henry7135/ouma-ria-smart-clock/OUMA CLOCK_ Wiring.pdf

# Connect Dupont jumper wires according to the wiring table

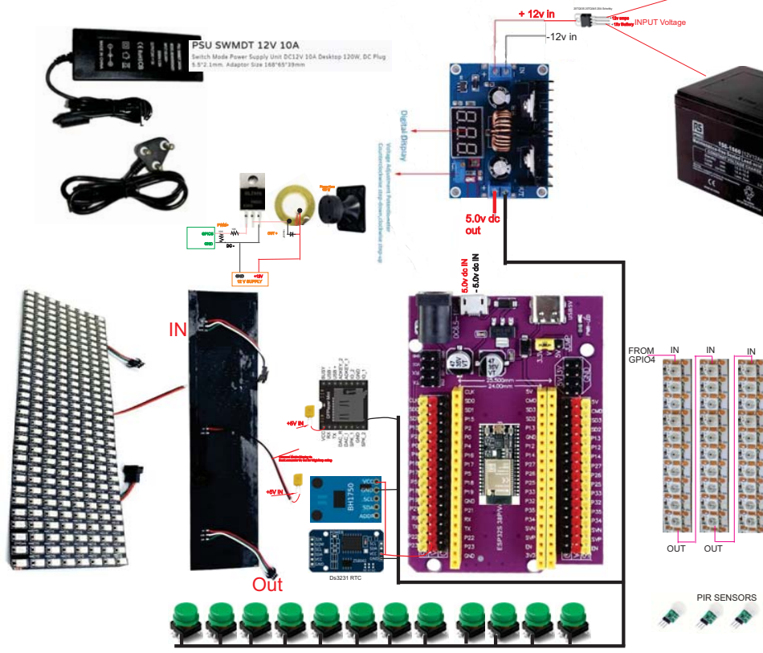
[picture p42: figure]
20TQ035 20TQ045 20A Schottky; 5.0v dc out; Out; OUT; +12v smps +12v Battery INPUT Voltage; Connect Matrix Display to; Ds3231 RTC; 12 V SUPPLY; Piezzo Horn 150 W; OUT +; GND; PWM+; GPIO5; GPIO4; FROM; PIR SENSORS

Buck converter 5v out for HighAmp rating

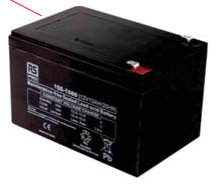
[picture p43: figure]

3w Speaker

Complete Pin Connection Table — from the firmware:

GPIO | Pin on ESP32 | Connect to | Notes
13 | GPIO13 | Matrix DATA IN | Main 16×32 display
4 | GPIO4 | BAR3 strip DATA IN | 30-LED status chain (3 strips in series)
21 | GPIO21 | SDA | DS3231 RTC + BH1750 (shared I²C bus)
22 | GPIO22 | SCL | DS3231 RTC + BH1750 (shared I²C bus)
16 | GPIO16 | DFPlayer TX → ESP RX1kΩ resistor on DFPlayer RX side
17 | GPIO17 | DFPlayer RX ← ESP TX1kΩ resistor in series here
5 | GPIO5 | Siren MOSFET gate | 10kΩ series + 10kΩ pulldown to GND
19 | GPIO19 | Button — MODE (red)
26 | GPIO26 | Button — SET (blue)
27 | GPIO27 | Button — UP (white)
14 | GPIO14 | Button — ALARM ON/OFF (white)
12 | GPIO12 | Button — CHIMES (red)LOW at boot is safe
32 | GPIO32 | Button — VOL UP (blue)
33 | GPIO33 | Button — VOL DOWN (yellow)
34 | External 10kΩ pull-up to 3.3V required GPIO34 | Button — SOUND (yellow) | (input-only pin)
35 | External 10kΩ pull-up to 3.3V required GPIO35 | Button — ALARM SELECT (red) | (input-only pin)
2 | GPIO2 | Button — WIFI RESET (blue)Hold 3s: WiFi/network reset. Short tap: Smoker quick-peek (when running)
18 | GPIO18 | Button — MEDICINE (yellow)
25 | GPIO25 | Button — BIRTHDAY (white)
15 | GPIO15 | PIR Courtyard BAM312 direct, 3.3V power
36 | GPIO36 | PIR Courtyard CInput-only, no internal pull
39 | GPIO39 | PIR Front Door (Zone 2)Input-only, no internal pull
23 | GPIO23 | PIR Passage (Zone 2)
0 | DO NOT USE GPIO0 | — | — boot strap pin
1 | DO NOT USE GPIO1 | — | — USB serial TX
3 | DO NOT USE GPIO3 | — | — USB serial RX / Ch340

Power rails summary:
Rail | Voltage | Feeds
Buck converter out | ESP32 board, DFPlayer, all LEDs 5.0V, 8A
12V PSU | Siren speakers (via IRLZ44N MOSFETs on GPIO5) 12V
Battery backup | Keeps 12V rail alive during loadshedding 12V
ESP32 3.3V out | DS3231, BH1750, AM312 PIR sensors, button pull-ups 3.3V
