henry7135/ouma-ria-smart-clock/Ouma Ria Smart Clock.ino

/******************************************************************************
 *
 *  OUMA RIA SMART CLOCK
 *  Version 1.0  --  Release Candidate 1
 *
 *  Designed and Developed by
 *      Henry Vermaak
 *      Koster, North West
 *      South Africa
 *
 *------------------------------------------------------------------------------
 *
 *  Project Purpose
 *
 *  The OUMA RIA SMART CLOCK is an ESP32-based home information, reminder
 *  and safety system developed to assist people in their everyday lives,
 *  with special attention given to older people living independently.
 *
 *  Every major feature was developed in response to a real-world need
 *  identified during daily use in the author's own home.
 *
 *  
 ******************************************************************************/

/******************************************************************************
 * FEATURE OVERVIEW
 ******************************************************************************/
//    NTP time sync        -- auto-syncs on boot + every 6 hours via WiFi
//    DS3231 RTC           -- temperature-compensated, +/-2ppm, built-in temp sensor
//    BH1750 light sensor  -- automatic day/night display brightness
//    Web config portal    -- browse to the clock's IP to set WiFi, time, volume
//    OTA updates          -- flash new firmware over WiFi, no USB cable needed
//    Automatic WiFi recovery -- reconnects on its own after a power outage,
//                               no button press required (manual backup kept)
//    Medicine reminders   -- up to 4 daily doses, plus two independent short
//                             courses (e.g. two different antibiotics at once)
//                             with Pushover reminders and phone acknowledgement
//    Birthday calendar, doctor appointments, and a general events calendar
//    Shopping / reminder notepad
//    Security alarm       -- 2 zones, 5 PIR sensors, siren, panic button,
//                             Pushover emergency alerts
//    Egg timer, smoker uptimer, braai timer, and a built-in braai times guide
//    Multiple alarms with day-of-week scheduling and snooze
//    Bilingual Afrikaans / English interface throughout
//    All settings stored in NVS -- survive firmware updates and power cuts

/******************************************************************************
 * HARDWARE
 ******************************************************************************/
//    DS3231 RTC         -- I2C  SDA=GPIO21  SCL=GPIO22   VCC=3.3V
//    BH1750 light       -- I2C  shared bus              VCC=3.3V
//    DFPlayer Mini      -- UART2  TX=GPIO17  RX=GPIO16   VCC=5V
//    4x 8x8 WS2812B     -- GPIO13  (470 ohm series resistor)
//    WS2812B 3x10 bar   -- GPIO4  (470 ohm series resistor)
//    Buttons (active LOW, INPUT_PULLUP unless noted):
//      GPIO19  BTN_MODE    -- cycle display modes              (Sw1  Red)
//      GPIO26  BTN_SET     -- adjust / start-pause egg timer    (Sw2  Blue)
//      GPIO27  BTN_UP      -- adjust / dismiss alarm / SNOOZE   (Sw3  White)
//      GPIO14  BTN_ALM     -- toggle alarm on/off               (Sw4  White)
//      GPIO12  BTN_CHIME   -- toggle chimes on/off              (Sw5  Red)
//      GPIO32  BTN_CVUP    -- volume up                         (Sw6  Blue)
//      GPIO33  BTN_CVDN    -- volume down                       (Sw7  Yellow, INPUT only)
//      GPIO34  BTN_SOUND   -- cycle sound set                   (Sw8  Yellow, INPUT only)
//      GPIO35  BTN_ALMSEL  -- reserved / spare                  (Sw9  Red,    INPUT only)
//      GPIO2   BTN_PILL    -- WiFi/network reset (hold 3s)      (Sw10 Blue)
//      GPIO18  BTN_MED     -- medicine confirm                  (Sw11 Yellow)
//      GPIO25  BTN_BDAY    -- birthday/doctor accept            (Sw12 White)
//    GPIO33, 34, 35 are input-only pins with no internal pull-up resistor --
//    fit an EXTERNAL 10K ohm pull-up to 3.3V on each of these three.

/******************************************************************************
 * WIRING SUMMARY
 ******************************************************************************/
//  Component            | Connection
//  --------------------- ----------------------------------------------------
//  DS3231 RTC           | SDA->GPIO21  SCL->GPIO22  VCC->3.3V  GND->GND
//  BH1750               | SDA->GPIO21  SCL->GPIO22  VCC->3.3V  GND->GND  ADDR->GND
//  DFPlayer Mini        | TX2(GPIO17)->DFP_RX  RX2(GPIO16)<-DFP_TX
//                        | 1K ohm resistor on DFPlayer RX pin. VCC->5V  GND->GND
//  WS2812B x4 panels    | DIN->GPIO13 (via 470 ohm)  VCC->5V (3A+)  GND->GND
//  WS2812B 3x10 bar     | DIN->GPIO4 (via 470 ohm)  VCC->5V  GND->GND
//    (one chain, cut      physical  0-9  = pill/appointment day strip
//     from one roll)      physical 10-19 = medicine dose + birthday indicators
//                         physical 20-29 = status: alarms, security, internet,
//                                          calendar, courtyard-armed, wekkers
//  Buttons x12          | one pin -> GPIO   other pin -> GND
//    GPIO33, 34, 35       EXTERNAL 10K ohm pull-up to 3.3V required
//    (input-only pins)    (no internal pull-up on 33/34/35/36/39)
//  Siren (piezo)         | GPIO5 -> IRLZ44N MOSFET gate, 10K series resistor,
//                          10K pull-down resistor to GND (prevents a boot chirp)
//  PIR sensors x5        | AM312, 3.3V, direct to GPIO, no divider needed

/******************************************************************************
 * DISPLAY MODES
 ******************************************************************************/
//    0 = Clock             amber
//    1 = Alarm set          cyan
//    2 = Egg timer run     green
//    3 = Egg timer set    orange
//    4 = Temperature      magenta (DS3231 built-in sensor, C or F)
//    5 = Uptime              blue (days.hours since boot)
//    Long-press BTN_MODE (>1s) toggles 12hr / 24hr display

/******************************************************************************
 * NETWORK, OTA & WEB PORTAL
 ******************************************************************************/
//    First boot: the clock creates a WiFi setup AP -- connect a phone to it
//    and follow the captive portal to enter your home WiFi credentials and
//    timezone offset. After that it connects automatically on every boot,
//    and retries automatically in the background if WiFi is down or drops
//    (loadshedding-safe -- no button press needed under normal conditions;
//    a manual hold-3-seconds reset button and a Restart button in /config
//    remain available as a backup). Time syncs on boot and every 6 hours.
//
//    OTA updates: Arduino IDE -> Sketch -> Upload -> select the clock's
//    network port. Set your own OTA_PASSWORD before flashing a real device.
//
//    Web portal pages include: / (status), /alarms, /wekkers, /medicine,
//    /calendar, /notepad, /alarm (security), /config, /set, /ota, and
//    several on-device reference pages (LED colour guide, button guide,
//    braai times).

/******************************************************************************
 * LIBRARIES (install via Arduino Library Manager)
 ******************************************************************************/
//    FastLED          by Daniel Garcia
//    RTClib           by Adafruit               (DS3231 driver)
//    BH1750           by Christopher Laws
//    WiFiManager      by tzapu                  (captive portal WiFi setup)
//    ArduinoOTA       (built into ESP32 Arduino core)
//    WebServer        (built into ESP32 Arduino core)
//    Preferences      (built into ESP32 Arduino core)
//    Wire             (built into ESP32 Arduino core)
//    time.h / sntp.h  (built into ESP32 Arduino core)
//    NOTE: DFRobotDFPlayerMini library is NOT needed -- a direct serial
//    driver is used instead.

/******************************************************************************
 * BOARD SETTINGS (Arduino IDE)
 ******************************************************************************/
//    Board:      ESP32 Dev Module
//    Flash Size: 4MB
//    Partition:  "Minimal SPIFFS (Large APPS with OTA)" -- REQUIRED for OTA;
//                do not use a "Huge APP" scheme, it removes the second OTA
//                app slot and disables over-the-air updates entirely.
//    CPU Speed:  240MHz
//    Upload:     921600 baud


// ── Arduino / ESP32 Core ──────────────────────────────────────────────────
#include <Arduino.h>
#include <Wire.h>                // I2C bus — shared by the RTC and light sensor
#include <time.h>                // system time / NTP (configTime, getLocalTime)

// ── Communications ──────────────────────────────────────────────────────────
#include <WiFiManager.h>         // tzapu WiFiManager — captive portal WiFi setup
#include <ESPmDNS.h>             // http://oumariaclock.local
#include <WiFiClientSecure.h>    // HTTPS client — Pushover notifications

// ── Display ────────────────────────────────────────────────────────────────
#include <FastLED.h>             // WS2812B main matrix + status strip

// ── RTC ────────────────────────────────────────────────────────────────────
#include <RTClib.h>              // Adafruit RTClib — DS3231 real-time clock

// ── Sensors ────────────────────────────────────────────────────────────────
#include <BH1750.h>              // ambient light sensor — auto-brightness

// ── Audio ──────────────────────────────────────────────────────────────────
// (none — DFPlayer Mini uses a direct UART serial driver, no library needed)

// ── Storage ────────────────────────────────────────────────────────────────
#include <Preferences.h>         // NVS key-value storage — all settings persist here

// ── Web Server ─────────────────────────────────────────────────────────────
#include <WebServer.h>           // config portal + status pages
#include <ArduinoOTA.h>          // over-the-air firmware updates

/******************************************************************************
 * VERSION INFORMATION
 ******************************************************************************/
#define FW_NAME        "OUMA RIA SMART CLOCK"
#define FW_VERSION     "1.0"
#define FW_STATUS      "Release Candidate 1"
#define FW_AUTHOR      "Henry Vermaak"

#define FIRMWARE_VERSION   FW_NAME " v" FW_VERSION   // used for the web footer / serial banner

/******************************************************************************
 * PIN DEFINITIONS — every physical GPIO assignment, in one place
 ******************************************************************************/
#define WS_PIN       13   // Main matrix WS2812B data
#define BTN_MODE     19   // NOTE: physical GPIO25 has a confirmed ~100 ohm stray
                          // leakage fault on this specific ESP32 module (measured
                          // directly on the pin with the button and wire fully
                          // removed — not a wiring/switch issue). BTN_MODE was
                          // moved here to GPIO19 and BTN_BDAY moved to GPIO25 below
                          // (a low-consequence role: its logic only fires silently
                          // when nothing is due, so a stray trigger there is
                          // harmless, unlike MODE's long-press which was falsely
                          // toggling C/F at every boot). Physical button wiring to
                          // be swapped to match — see BTN_BDAY comment below.
#define BTN_SET      26
#define BTN_UP       27
#define BTN_ALM      14
#define BTN_CHIME    12
#define BTN_CVUP     32
#define BTN_CVDN     33
#define BTN_SOUND    34   // input-only — needs external 10K pull-up to 3.3V
#define BTN_ALMSEL   35   // input-only — needs external 10K pull-up to 3.3V
#define BTN_PILL      2   // pill confirm / repurposed: hold 3s = WiFi/network reset
#define BTN_MED      18   // medicine confirm (INPUT_PULLUP)
#define BTN_BDAY     25   // birthday/doctor accept (INPUT_PULLUP) — deliberately
                          // parked on the faulty pin (see BTN_MODE note above).
                          // Physical wires: swap the MODE and BIRTHDAY button
                          // wires between GPIO19 and GPIO25 so the panel labels
                          // once again match their real function.
#define DFP_RX_PIN   16   // ESP32 RX ← DFPlayer TX
#define DFP_TX_PIN   17   // ESP32 TX → DFPlayer RX
#define BAR3_PIN      4   // single WS2812B data pin — ONE chain, cut from one roll:
                          //   physical 0-9   = day-of-week / pill strip
                          //   physical 10-19 = medicine dose + birthday/doctor LEDs
                          //   physical 20-29 = free/status bar (alarm, internet, calendar...)
#define PIR_PARKED  255   // sentinel: PIR slot with no GPIO — always reads "no motion"
#define PIR1_PIN   PIR_PARKED // Zone 1 Courtyard sensor A — no free GPIO remains on
                          // this board; see the wiring note further down for a
                          // PCF8575 I2C expander as the clean way to add it back
#define PIR2_PIN     15   // Zone 1 Courtyard sensor B  (INPUT, always armed)
                          // GPIO15 LOW at boot is safe — only silences ROM boot log
#define PIR3_PIN     36   // Zone 1 Courtyard sensor C  (input-only, always armed)
#define PIR4_PIN     39   // Zone 2 Front door/Entrance (input-only, arm-away only)
#define PIR5_PIN     23   // Zone 2 Passage/Lounge      (INPUT,      arm-away only)
#define SIREN_PIN     5   // IRLZ44N MOSFET gates — needs 10K gate pulldown resistor

/******************************************************************************
 * CONSTANTS — global, cross-cutting values. Subsystem-local sizing constants
 * (e.g. how many Kort Kursus slots, how many calendar events) stay next to
 * the struct/array they configure, further down in each subsystem's section.
 ******************************************************************************/

// -- Firmware behaviour -------------------------------------------------------
#define PILLS_ENABLED  0   // 0 = daily-pills subsystem disabled (the Medicine
                           // schedule below covers it). Set to 1 to re-enable.
#define SPLASH_MAJOR  1   // boot splash scrolls "V <MAJOR>.<MINOR>" on the LED
#define SPLASH_MINOR  0   // matrix — UPDATE THESE TOGETHER WITH FW_VERSION!
                          // (single digits 0-9 only: they index FONT5 directly)

// -- NTP / time ----------------------------------------------------------------
#define NTP_SERVER1        "pool.ntp.org"
#define NTP_SERVER2        "time.google.com"
#define NTP_SYNC_INTERVAL  (6UL * 3600UL)     // resync every 6 hours (seconds)

// -- WiFi / network --------------------------------------------------------------
// If WiFi can't connect (or drops mid-session, e.g. a power outage), the
// clock keeps retrying by itself in the background, forever, with no button
// press or menu needed. See wifi_connect_with_retries() and the WiFi-health
// check inside wifi_task()'s main loop.
#define OTA_PASSWORD       "CHANGE_ME"        // set your own password before flashing
#define WIFI_CONNECT_ATTEMPT_TIMEOUT_MS   15000            // how long ONE attempt waits before giving up
#define WIFI_RETRY_FIRST_WAIT_MS          (60UL * 1000UL)  // wait 60s before the very first retry
#define WIFI_RETRY_INTERVAL_MS            (3UL * 60UL * 1000UL)  // then retry every 3 minutes, forever
#define WIFI_HEALTH_CHECK_INTERVAL_S      60               // how often to notice a mid-session drop
#define WIFI_BTN_HOLD_MS                  3000             // hold BTN_PILL this long for a manual WiFi/reboot reset
#define INET_CHECK_INTERVAL               30               // seconds between internet-reachability probes
// Diagnostic switch — set to 0 to fully disable WiFi/NTP/OTA/webserver, e.g.
// for isolating whether background WiFi activity affects DFPlayer audio.
#define ENABLE_WIFI  1

// -- Rollover-safe millis() deadline check ----------------------------------------
// Fixes a subtle rollover bug found on review: code of the form
//   end = millis() + duration;   ... later ...   if (millis() >= end) { ... }
// looks fine, but millis() wraps back to 0 roughly every 49.7 days. If a
// timer is armed close enough to the wrap that "millis() + duration" itself
// overflows past 4,294,967,295, "end" comes out as a SMALL number even
// though it represents a point still in the future — and a plain ">="
// comparison then trips immediately (or in the case of "<", never trips),
// firing early or late for one timer, exactly once, until the wrap has
// fully passed. Unsigned subtraction doesn't have this problem: casting
// the difference to a signed 32-bit value gives the correct sign even
// across a wraparound, as long as the two timestamps are within ~24.8 days
// of each other (true for every timer in this firmware — all are seconds
// long). Use TIME_REACHED(now, deadline) wherever a "millis() + duration"
// deadline is compared against the current time.
#define TIME_REACHED(now, deadline)  ((int32_t)((now) - (deadline)) >= 0)

// -- General behaviour -----------------------------------------------------------
#define BUTTON_SETTLE_MS   2000                // ignore hold/long-press logic for this
                                                // long after loop() first starts scanning
                                                // buttons — lets every GPIO settle through
                                                // its pull-up before the firmware trusts it
#define SNOOZE_MINUTES     9
#define SMOKE_PEEK_MS      5000                // how long the quick smoker-uptime peek stays on screen
#define NIGHT_START        18   // winter — sun sets 18:00
#define NIGHT_END           7   // winter — sun rises 07:00
#define NUM_ALARM_SLOTS    3

// -- Security alarm timing --------------------------------------------------------
#define ZONE1_COUNT  3    // Outdoor courtyard sensors  (24/7, immediate siren)
#define ZONE2_COUNT  2    // Indoor sensors             (away mode, entry delay)
#define PIR_COUNT    5
#define ALARM_EXIT_DELAY_S   30
#define ALARM_ENTRY_DELAY_S  30
#define ALARM_SIREN_TIMEOUT_S   180   // PIR alarm auto-resets after 3 minutes (power-saving when away)
#define PANIC_SIREN_TIMEOUT_S   900   // Panic siren runs 15 minutes independently
#define DISARM_LOCKOUT_MS      8000   // 8s lockout — covers AM312 worst-case hold time

// -- Pushover / notifications ------------------------------------------------------
// Get your own free credentials at https://pushover.net :
//   1. Create an account and install the Pushover app on your phone.
//   2. Your "User Key" is shown on the dashboard after login.
//   3. Create an "Application" (Settings > Applications > Create New App)
//      to get an "API Token/Key". Name it whatever you like.
// Paste your own values below. NEVER commit real tokens to a public repo.
#define PO_APP_TOKEN  "YOUR_PUSHOVER_APP_TOKEN_HERE"
#define PO_USER_KEY   "YOUR_PUSHOVER_USER_KEY_HERE"
#define PO_HOST       "api.pushover.net"
#define PO_QUEUE_SIZE 8
#define PO_RETRY_SECS   60     // priority-2 re-alert interval (panic/intruder)
#define PO_EXPIRE_SECS  3600   // priority-2 gives up after this (1 hour)
// Medicine reminder pacing — gentler than panic: re-alert every 5 min for up
// to 30 min, until someone taps Acknowledge in the Pushover app.
#define MED_PUSHOVER        1     // 0 = no Pushover for medicine doses
#define MED_PO_LEAD_MIN     5     // warn the phone this many minutes BEFORE the dose
#define MED_PO_RETRY_SECS   300
#define MED_PO_EXPIRE_SECS  1800

// -- Display / LED hardware --------------------------------------------------------
#define NUM_LEDS     256
#define LED_TYPE     WS2812B
#define COLOR_ORDER  GRB
#define BAR3_NUM_LEDS  30
#define MED_NUM_LEDS  8   // Sunlephant board (we use up to 4 = max doses)
#define PILL_NUM_LEDS 8   // Sunlephant 8 LEDs (we use 7 = Sun-Sat, LED7 off)

// -- Display / LED layout — index positions on the shared BAR3 strip --------------
#define PILL_BASE       0
#define MED_BASE       10
#define FREE_BASE      20
#define BDAY_LED_3   4    // med_leds[4] = 3 days before birthday
#define BDAY_LED_2   5    // med_leds[5] = 2 days before birthday
#define BDAY_LED_1   6    // med_leds[6] = tomorrow / today birthday
#define DOC_LED      7    // pill_leds[7] = doctor appointment indicator

// -- Audio track numbers (DFPlayer SD card) ----------------------------------------
#define MED_TRACK    62   // "Medisyne tyd Ouma!"  — above all chime tracks (max=53)
#define BDAY_TRACK   63   // birthday song
#define DOC_TRACK    64   // "Doktersafspraak vandag!"
#define PILL_TRACK   61   // "Pille geneem!" (PILLS_ENABLED only)

// -- Medicine / birthday / doctor limits ------------------------------------------
#define MED_MAX_DOSES 4   // maximum doses per day
#define MED_START_HH  7   // medicine window start hour (07:00)
#define MED_END_HH   19   // medicine window end hour  (19:00)
#define BDAY_MAX     30   // maximum birthday entries (30 — lots of grandchildren!)
#define DOC_MAX      10   // maximum doctor appointment entries

/******************************************************************************
 * SECURITY ALARM — WIRING NOTES
 ******************************************************************************/
//  GPIO 0, 1 and 3 are NOT used for any peripheral on this board. GPIO0 is
//  the boot-strapping pin (must read HIGH at reset, or the board drops into
//  the serial bootloader); a sensor idling LOW there can prevent boot
//  entirely. GPIO1 carries the boot log at every reset. GPIO3 is driven by
//  the on-board USB-serial chip whenever the board is powered through its
//  USB socket — loading a peripheral onto it caused real, hard-to-diagnose
//  failures (intermittent notification/Wi-Fi problems) during development.
//  Treat all three as reserved for USB/serial only.
//
//  PIR sensors: AM312 — VCC=3.3V, GND=GND, OUT→GPIO (direct, no resistor needed)
//  Siren: 2x piezo tweeter, each via an IRLZ44N MOSFET
//    GPIO5 ──[10KΩ series]──► Gate IRLZ44N #1  Drain→Speaker1(-)  Source→GND
//    GPIO5 ──[10KΩ series]──► Gate IRLZ44N #2  Drain→Speaker2(-)  Source→GND
//    Both Speaker(+) → 12V supply.  Add a 1N4007 diode across each speaker.
//    REQUIRED: one 10KΩ pull-down resistor from the gate side to GND (a
//    single shared resistor covers both gates; ready-made 2-channel MOSFET
//    driver modules usually include one) — this defeats GPIO5's weak
//    internal pull-up at reset so the siren can't chirp during boot.
//  PIR1 (Zone 1 Courtyard A) has no free GPIO left on this board and is
//  parked (see PIR1_PIN in Pin Definitions above) — a PCF8575 I2C expander
//  is the clean way to add it back if you have a free I2C address to spare.

/******************************************************************************
 * GLOBAL VARIABLES — organized by subsystem, subsystem-local sizing
 * constants (array/struct sizing) stay right next to the variables they
 * configure rather than living in the Constants block above.
 ******************************************************************************/

// -- Pushover — runtime state -----------------------------------------------
// Result of the most recent po_send attempt — shown on /alarm and /potest so
// Pushover problems are diagnosable from the phone, no serial cable needed.
String g_po_last = "geen poging nog / no attempt yet";


/******************************************************************************
 * 5x7 FONT — clean outline style (open/hollow, like a 7-segment display)
 ******************************************************************************/
// Indices: 0-9 digits, 10=colon, 11=space, 12=V, 13=dot, 14=dash, 15=C, 16=F
//          17=° degree symbol
// Bit 6 = top row, bit 0 = bottom row. Each byte is one vertical column.
const uint8_t FONT5[18][5] = {
  {0x7F,0x41,0x41,0x41,0x7F},  //  0  full border, hollow centre
  {0x00,0x42,0x7F,0x40,0x00},  //  1  serif top-left + vertical bar + foot
  {0x79,0x49,0x49,0x49,0x4F},  //  2  top-right + mid + bottom-left
  {0x49,0x49,0x49,0x49,0x7F},  //  3  mid + right side full
  {0x0F,0x08,0x08,0x08,0x7F},  //  4  top-left + mid + right
  {0x4F,0x49,0x49,0x49,0x79},  //  5  top-left + mid + bottom-right
  {0x7F,0x49,0x49,0x49,0x79},  //  6  left side + mid + bottom-right
  {0x01,0x01,0x01,0x01,0x7F},  //  7  top bar + right side
  {0x7F,0x49,0x49,0x49,0x7F},  //  8  full border + mid bar
  {0x4F,0x49,0x49,0x49,0x7F},  //  9  top-left + mid + right side
  {0x00,0x36,0x36,0x00,0x00},  // 10  colon — two small dots
  {0x00,0x00,0x00,0x00,0x00},  // 11  space
  {0x3F,0x40,0x40,0x40,0x3F},  // 12  V — outline chevron
  {0x00,0x60,0x60,0x00,0x00},  // 13  dot — bottom area
  {0x08,0x08,0x08,0x08,0x08},  // 14  dash / minus
  {0x38,0x44,0x44,0x44,0x00},  // 15  c — baseline aligned with digits (Oupa's view)
  {0x7F,0x09,0x09,0x01,0x01},  // 16  F — top + mid bars + left side
  {0x06,0x09,0x09,0x06,0x00},  // 17  ° — small open circle
};

// ── Colour themes ─────────────────────────────────────────────────────────────
// Index:  0=clock  1=alarmset  2=egg  3=temp  4=uptime
const uint8_t THR[5] = {255,   0,   0, 220,   0};
const uint8_t THG[5] = {140, 220, 200,   0, 100};
const uint8_t THB[5] = {  0, 220,   0, 220, 255};

// ── FastLED array ─────────────────────────────────────────────────────────────
CRGB leds[NUM_LEDS];
CRGB pill_leds[PILL_NUM_LEDS];   // Sunlephant day-of-week LEDs (mirrored into bar3_leds)
CRGB med_leds[MED_NUM_LEDS];     // Sunlephant medicine dose LEDs (mirrored into bar3_leds)
CRGB bar3_leds[BAR3_NUM_LEDS];   // THE physical 30-LED chain on BAR3_PIN: pills+meds+free/status

// ── Hardware objects ──────────────────────────────────────────────────────────
RTC_DS3231   rtc;
BH1750       lightMeter;
WebServer    webServer(80);

// ── Time globals ──────────────────────────────────────────────────────────────
uint8_t  g_hh = 12, g_mm = 0, g_ss = 0;
uint8_t  g_day = 1, g_month = 1;   // for date display
uint16_t g_year = 2026;            // Full year, kept fresh by rtc_sync()
uint8_t  g_dow  = 0;               // Day of week 0=Sun..6=Sat, cached by rtc_sync()
int16_t  g_tz_offset_hours = 2;    // timezone offset from UTC (e.g. SAST = +2)
bool     g_use_12hr  = false;       // 12hr/24hr display
bool     g_temp_degF = false;       // false=°C (default), true=°F — separate from clock mode
bool     g_ntp_synced = false;     // true after first NTP sync
// Once-per-minute latch, set in the 1s tick — replaces
// all the fragile "g_ss == 0" exact-second triggers. See timekeeping().
bool     g_new_minute = false;


// -- Medicine schedule globals ------------------------------------------------
// Dose times: set via web portal, saved to NVS
// doses_per_day = 0 means medicine finished / no current script
struct MedDose {
  uint8_t hh;       // hour
  uint8_t mm;       // minute
  bool    taken;    // confirmed taken today
};

uint8_t  g_med_doses     = 2;       // doses per day: 0,1,2,3,4
MedDose  g_med[MED_MAX_DOSES] = {   // default schedule
  { 7,  0, false},   // dose 1: 07:00
  {13,  0, false},   // dose 2: 13:00
  {19,  0, false},   // dose 3: 19:00 (used when doses>=3)
  {16,  0, false},   // dose 4: 16:00 (used when doses==4)
};
bool     g_med_btn_prev   = false;  // debounce for medicine button
uint8_t  g_med_alm_active  = 255;   // which dose is currently alarming (255=none)
uint32_t g_med_last_day    = 255;   // day-of-week when med was last reset

// -- Kort Kursus / Short Course globals (LED 7 on Strip 2) --
// TWO independent course slots — Ria's own real case: two different
// antibiotics for pneumonia, on two different schedules, running at the
// same time. One shared course slot couldn't hold both. Same
// pattern as the three Wekkers slots — each course is fully independent:
// own name, own dose count/times, own day countdown. Struct-based so the
// slot count can grow later by just changing COURSE_SLOTS.
#define COURSE_SLOTS     2
#define COURSE_MAX_DOSES 4
struct Course {
  char    name[24];                          // e.g. "Ciprofloxactin 500mg"
  uint8_t doses;                              // 0 = this slot is inactive
  uint8_t hh[COURSE_MAX_DOSES];
  uint8_t mm[COURSE_MAX_DOSES];
  bool    taken[COURSE_MAX_DOSES];
  uint8_t days_total;
  uint8_t days_left;                          // counts down; 0 = inactive/finished
  uint8_t last_day;                           // g_day when this slot last rolled over
};
Course   g_course[COURSE_SLOTS] = {
  { "", 0, {8, 14, 20, 0}, {0,0,0,0}, {false,false,false,false}, 0, 0, 255 },
  { "", 0, {9, 21,  0, 0}, {0,0,0,0}, {false,false,false,false}, 0, 0, 255 },
};
uint8_t  g_course_alm_slot = 255;   // which slot is currently alarming (255=none)
uint8_t  g_course_alm_dose = 255;   // which dose within that slot

// -- Ad-hoc extra dose log ----------------------------------------------------
// Henry's follow-up: the Kort Kursus scheduler (above) covers a real course
// with fixed times, but there's a SEPARATE everyday need it doesn't cover —
// an unscheduled one-off, e.g. "Ouma needs an extra painkiller right now."
// No time to set, no multi-day count, just "log that this happened today."
// This is what the old single on/off toggle actually did, restored here as
// its own simple log rather than folded into the scheduled course.
#define ADHOC_MAX_LOG 6
uint8_t  g_adhoc_count    = 0;               // how many logged today
uint8_t  g_adhoc_hh[ADHOC_MAX_LOG];          // time of each log entry
uint8_t  g_adhoc_mm[ADHOC_MAX_LOG];
uint8_t  g_adhoc_last_day = 255;             // day-of-week reset detector, same pattern as med_check_reset

// ── Birthday Calendar globals ─────────────────────────────────────────────────
struct Birthday {
  uint8_t  day;          // 1–31
  uint8_t  month;        // 1–12
  char     name[14];     // first name, max 13 chars + null
};
Birthday g_bdays[BDAY_MAX];
uint8_t  g_bday_count       = 0;    // how many entries are set
bool     g_bday_today       = false; // someone has a birthday today
uint8_t  g_bday_today_idx   = 255;  // index of today's birthday (255 = none)
bool     g_bday_acked        = false; // accept button pressed today — stop flashing
uint8_t  g_bday_last_day    = 255;  // day-of-month when we last checked/reset ack
bool     g_bday_played      = false; // MP3 already played today
bool     g_bday_btn_prev    = false; // debounce for BTN_BDAY

// ── Doctor Appointment Calendar globals ───────────────────────────────────────
struct DocAppt {
  uint8_t  day;          // 1–31
  uint8_t  month;        // 1–12
  char     desc[16];     // short description e.g. "Dr Botha" max 15 chars
};
DocAppt  g_docs[DOC_MAX];
uint8_t  g_doc_count      = 0;    // how many appointments are set
bool     g_doc_today      = false; // appointment today
uint8_t  g_doc_today_idx  = 255;  // index of today's appointment
bool     g_doc_acked      = false; // accept button pressed today
uint8_t  g_doc_last_day   = 255;  // day-of-month when ack last reset
bool     g_doc_played     = false; // MP3 already played today
bool     g_doc_warned     = false; // evening-before warning already played

// ── Kalender general-event globals ──────────────────
// General events ("Ria vergadering", "kar diens") for the /calendar month
// grid. Same day/month + auto-purge pattern as doctor appointments — no year
// stored, past events purge once the date wraps. LED: BAR3 slot 28.
#define EVT_MAX 20
struct Evt {
  uint8_t  day;          // 1–31
  uint8_t  month;        // 1–12
  char     desc[24];     // short description, max 23 chars + null
};
Evt      g_events[EVT_MAX];
uint8_t  g_evt_count      = 0;
bool     g_evt_today      = false;  // any event today (drives LED pulse)
bool     g_evt_acked      = false;  // accept button pressed today — stop flashing
int16_t  g_evt_days_min   = 999;    // days to the NEAREST upcoming event
uint8_t  g_evt_last_day   = 255;    // new-day detector for purge + notify reset
bool     g_evt_notified   = false;  // 07:00 Pushover sent today

// ── Notaboekie globals (Ouma's request) ─────────────────────────────────────
// Small shopping/reminder notes: tap ✓ to strike through when bought, X to
// delete, "Vee gedoen uit" clears all completed. NVS-persisted like all else.
#define NOTE_MAX 20
struct Note {
  char text[41];   // max 40 chars
  bool done;
};
Note     g_notes[NOTE_MAX];
uint8_t  g_note_count = 0;

// -- Pill reminder globals ---------------------------------------------------
bool     g_pill_taken     = false;   // did Ouma take her pills today?
uint8_t  g_pill_last_day  = 255;     // day-of-week when pill was last confirmed
uint8_t  g_pill_alm_hh    = 8;       // pill reminder alarm hour
uint8_t  g_pill_alm_mm    = 0;       // pill reminder alarm minute
bool     g_pill_alm_en    = true;    // pill reminder alarm enabled
bool     g_pill_alm_fire  = false;   // pill reminder currently firing
bool     g_pills_active   = true;    // true = Ouma must take daily pills (set via web portal)
uint32_t g_pill_pulse_ms  = 0;       // for pulsing the LEDs during alarm
bool     g_pill_btn_prev  = false;   // debounce for pill button

// ── WiFi/network reset button (repurposed GPIO2/BTN_PILL, pill subsystem
// retired — see wifi_reset_check_button()) ─────────────────────────────────
bool     g_wifi_btn_prev     = false;   // debounce
uint32_t g_wifi_btn_down_ms  = 0;       // millis() when button was first pressed (0 = not held)
bool     g_wifi_btn_fired    = false;   // true once this press has already triggered a restart

// -- Alarm ----------------------------------------------------------------------
// A single daily wake alarm — no day-of-week mask, fires every day.
struct Alarm {
  uint8_t hh;
  uint8_t mm;
  bool    enabled;
};
Alarm g_alarm1 = {6, 30, true};

// -- Wekkers — three independent daily alarms, separate from the wake alarm ------
// above. Each has its own time, its own day-of-week mask, and its own
// enabled state. A firing Wekker repeats every WEKKER_REPEAT_MS (0002.mp3 is
// short enough to miss on a single play) until acknowledged via BTN_BDAY —
// the same accept/dismiss button shared with birthdays and doctor
// appointments — or until WEKKER_MAX_REPEATS is reached.
bool    g_wekker_enabled[NUM_ALARM_SLOTS]     = {false, false, false};
uint8_t g_wekker_hh[NUM_ALARM_SLOTS]          = {6, 7, 8};
uint8_t g_wekker_mm[NUM_ALARM_SLOTS]          = {0, 0, 0};
uint8_t g_wekker_days[NUM_ALARM_SLOTS]        = {0x7F, 0x7F, 0x7F};
bool    g_wekker_fired_today[NUM_ALARM_SLOTS] = {false, false, false};
#define WEKKER_REPEAT_MS     20000UL   // 20 seconds between repeats
#define WEKKER_MAX_REPEATS   6         // give up after this many repeats (~2 min)
bool     g_wekker_ringing      = false;  // true from first fire until accepted/expired
uint8_t  g_wekker_repeat_count = 0;      // how many times it has played this ringing session
uint32_t g_wekker_last_play_ms = 0;      // millis() of the most recent play
uint8_t g_wekker_slot = 0;   // which slot is being edited on the web page

// ── Flags ─────────────────────────────────────────────────────────────────────
volatile bool g_colon     = false;
bool g_alm_fire   = false;
uint32_t g_alm_fire_ms = 0;   // millis() when g_alm_fire became true — for 3-min auto-stop
volatile bool g_force_redraw = false;  // set true to skip render() 100ms throttle once
bool g_alm_armed  = true;
bool g_chime_en   = true;
bool g_chime_req  = false;
bool g_show_set   = false;
bool g_show_date  = false;

// ── Egg timer ─────────────────────────────────────────────────────────────────
bool     g_egg_run     = false;
bool     g_egg_done    = false;   // finished, waiting to be dismissed — separate from the main alarm
uint32_t g_egg_done_ms = 0;       // millis() when it finished, for the 10s auto-clear
uint8_t  g_egg_set_mm = 5, g_egg_set_ss = 0;   // remembered preference — saved to NVS
uint8_t  g_egg_mm = 5, g_egg_ss = 0;           // live countdown — NOT saved, resets on reboot

// ── Smoker Uptimer ───────────────────────────────────────────────────────────
// Counts UP, not down — for tracking how long meat's been in the smoker.
// RTC-based (not millis()-based) and saved to NVS on every state change, so a
// power cut mid-smoke (loadshedding!) doesn't lose the elapsed time — on next
// boot it just keeps counting from where it actually is, using real wall-clock
// time from the battery-backed DS3231, not time since the ESP32 last rebooted.
bool     g_smoke_running      = false;
bool     g_smoke_paused       = false;
uint32_t g_smoke_start_unix   = 0;   // rtc.now().unixtime() when Start pressed
uint32_t g_smoke_pause_unix   = 0;   // rtc.now().unixtime() when Pause pressed
uint32_t g_smoke_paused_accum = 0;   // total seconds spent paused so far
String   g_smoke_note         = "";  // optional: "3kg pork leg" etc.
uint32_t g_smoke_last_reminder = 0;  // which 30-min boundary last triggered a beep
bool     g_smoke_peek_active   = false;  // quick-look overlay currently showing on the matrix
uint32_t g_smoke_peek_end_ms   = 0;      // millis() when the overlay should auto-clear

// ── Braai Timer (Ouma's idea!) ────────────────────────────────────────────────
// Counts DOWN from a selected total cook time, with a repeating turn-reminder
// at a selected interval (e.g. "turn every 1 minute"). Same RTC-based survive-
// reboot pattern as the Smoker Uptimer above — a power blip mid-braai doesn't
// lose the countdown. Plays 0025.mp3 on every turn boundary, and a distinct
// "done" sound (track 2, the egg-timer alert) when the total time is up, so
// the two cues sound different by ear.
bool     g_braai_enabled      = false;  // tickbox — must be on for the page/timer to run
bool     g_braai_running      = false;
bool     g_braai_paused       = false;
uint32_t g_braai_start_unix   = 0;      // rtc.now().unixtime() when Start pressed
uint32_t g_braai_pause_unix   = 0;      // rtc.now().unixtime() when Pause pressed
uint32_t g_braai_paused_accum = 0;      // total seconds spent paused so far
uint16_t g_braai_total_sec    = 600;    // selected total cook time, default 10 min
uint16_t g_braai_turn_sec     = 60;     // selected turn interval, default 1 min
uint32_t g_braai_last_turn    = 0;      // which turn-interval boundary last triggered a beep
bool     g_braai_done_played  = false;  // "time's up" sound already played this session

// ── Chime ─────────────────────────────────────────────────────────────────────
uint8_t g_chime_done_mm = 61;
// Voice-priority lock. Any spoken announcement (medisyne,
// dokter, verjaarsdag, pille, egg alert) records its minute here; the chime
// yields for that minute instead of cutting the voice off mid-word (the
// DFPlayer obeys whoever spoke LAST, and the chime request was consumed after
// the announcements in the same tick — so the chime always won). 61 = none.
// Cleared automatically as soon as the minute moves on, so a med dose at
// 08:00 doesn't wrongly silence the 09:00 chime as well.
uint8_t g_voice_lock_mm = 61;
inline void voice_lock(void) { g_voice_lock_mm = g_mm; }
uint8_t g_chime_track   = 0;

// ── Sound & volume ────────────────────────────────────────────────────────────
uint8_t g_sound_set  = 0;
uint8_t g_vol        = 20;
uint8_t g_night_vol  = 8;
// Alarm volume — separate from day/night ambient volume so a quiet
// night/day setting never makes Alarm or Wekkers too soft to actually wake
// you. Used by both Alarm and Wekkers, including their repeat loops — day/
// night volume is ignored for these specifically.
uint8_t g_alarm_vol  = 25;
uint8_t g_show_timer = 0;

// ── Mode ──────────────────────────────────────────────────────────────────────
uint8_t g_mode = 0;
// 0=clock 1=alarm-set 2=egg-run 3=egg-set 4=temperature 5=uptime

// ── Brightness ────────────────────────────────────────────────────────────────
// Two independent values — see update_brightness_smooth() and leds_show_all()
// for why. g_bright/g_bright_target = MAIN DISPLAY, still BH1750 lux-driven.
// g_bar3_bright/g_bar3_bright_target = BAR3 (pills/meds/status), fixed
// day/night schedule via g_bright_day/g_bright_night.
uint8_t g_bright        = 120;
uint8_t g_bright_target = 120;  // smooth fade target
uint8_t g_bar3_bright        = 120;
uint8_t g_bar3_bright_target = 120;
uint8_t g_bright_day    = 180;
uint8_t g_bright_night  = 40;

// ── Idle / rainbow ────────────────────────────────────────────────────────────
uint32_t g_last_interaction_ms = 0;
bool     g_rainbow_active      = false;
uint8_t  g_rainbow_hue         = 0;

// ── Snooze ────────────────────────────────────────────────────────────────────
bool    g_snooze_active   = false;
uint8_t g_snooze_hh       = 0;
uint8_t g_snooze_mm       = 0;

// ── Security alarm globals ────────────────────────────────────────────────────
// Sensor arrays — Zone 1 first (indices 0..ZONE1_COUNT-1), Zone 2 after
const uint8_t PIR_PINS[PIR_COUNT]  = {PIR1_PIN, PIR2_PIN, PIR3_PIN, PIR4_PIN, PIR5_PIN};
const char* PIR_NAMES[PIR_COUNT]   = {"Courtyard A","Courtyard B","Courtyard C","Front door","Passage"};
const char* PIR_ZONES[PIR_COUNT]   = {"Zone 1","Zone 1","Zone 1","Zone 2","Zone 2"};

// Single guarded PIR reader — a slot whose pin is
// PIR_PARKED (255, currently Courtyard A) always reads "no motion" instead of
// digitalRead()-ing a pin that doesn't exist. All of check_pir() goes
// through here, so re-homing a sensor later (e.g. onto the PCF8575) only
// needs this one function to change.
static inline bool pir_read(uint8_t i) {
  if (PIR_PINS[i] == PIR_PARKED) return false;
  return digitalRead(PIR_PINS[i]) == HIGH;
}

// ── Alarm state machine ───────────────────────────────────────────────────────
// Zone 1 (outdoor courtyard) — always armed 24/7, fires siren immediately
// Zone 2 (indoor)            — armed only when away, has exit+entry delay
bool     g_z1_active       = true;   // Zone 1 always on (set false to suspend)
bool     g_z2_armed        = false;  // Zone 2 armed (away mode)

// Shared siren state
bool     g_sec_triggered   = false;  // siren is wailing
uint8_t  g_trig_zone       = 0;      // which zone triggered (1 or 2)
uint8_t  g_trig_sensor     = 0;      // which sensor index triggered

// Zone 2 exit/entry delay
bool     g_sec_exit_delay  = false;  // true = counting down exit delay
bool     g_sec_entry_delay = false;  // true = motion seen, grace period running
uint32_t g_sec_arm_ms      = 0;      // millis() when Zone 2 armed
uint32_t g_sec_entry_ms    = 0;      // millis() when entry delay started

// Disarm flag — set by web handler, cleared by check_pir on next loop pass
// This fixes the bug where disarm during exit delay was ignored
bool     g_disarm_requested = false;

// Panic button — set by web handler, fires siren immediately, zone 0 = panic
bool     g_panic_requested  = false;

// Auto-reset: timestamp when siren started — resets after ALARM_SIREN_TIMEOUT_S
uint32_t g_siren_start_ms   = 0;

// Panic has its own independent siren timer (15 min, manual stop only)
bool     g_panic_active     = false;   // true = panic siren running
uint32_t g_panic_start_ms   = 0;       // millis() when panic was pressed

// Post-disarm lockout — prevents PIR retriggering immediately after disarm
// (AM312 holds its output HIGH for ~2s after movement stops)
uint32_t g_disarm_lockout_ms = 0;      // millis() when disarm completed; 0 = no lockout

// ── Uptime ────────────────────────────────────────────────────────────────────
uint32_t g_boot_time_unix = 0;   // unix timestamp at boot (set after NTP sync)

// ── Temperature flip (auto-show temp for 3s, 5s after each minute tick) ──────
bool     g_temp_flip_active = false;   // currently showing temp overlay in clock mode
uint32_t g_temp_flip_end_ms = 0;       // millis() when the flip ends
uint8_t  g_last_flip_mm     = 255;     // Half-minute key (mm*2+half, 0-119; 255=never) we last triggered on

// ── Timing ────────────────────────────────────────────────────────────────────
uint32_t g_last_sec_ms   = 0;
uint32_t g_last_half_ms  = 0;
uint32_t g_last_btn_ms   = 0;
uint32_t g_last_ntp_sync = 0;   // millis() of last NTP write to RTC
// Live internet-reachability indicator for BAR3 LED 27.
// WiFi-connected only means the router link is up; it says nothing about the
// fibre/uplink being alive (loadshedding: router on UPS, ONT dead). This
// tracks whether the ESP32 could actually reach the outside world recently.
bool     g_inet_ok       = false;   // last reachability probe result
uint32_t g_last_inet_chk = 0;       // millis() of last probe
bool     g_dfp_alive     = false;   // did the DFPlayer respond to the boot diagnostic?
                                     // shown permanently on the free bar — no serial needed
uint32_t g_last_wifi_retry = 0;     // millis() of last mid-session reconnect attempt
// True while an OTA update is receiving — loop() on
// Core 1 stands down from all rendering so Core 0's OTA progress bar owns
// FastLED exclusively (see the render-race note at ArduinoOTA.onStart).
volatile bool g_ota_active = false;
uint8_t  g_rtc_tick      = 0;
uint8_t  g_lux_tick      = 0;

// ── Button hold-to-repeat ─────────────────────────────────────────────────────
uint32_t g_hold_ms  = 0;
uint8_t  g_hold_btn = 0;

// ── Button debounce ───────────────────────────────────────────────────────────
uint16_t btn_prev = 0xFFFF;

// ── Button bit masks ─────────────────────────────────────────────────────────
#define BMASK_MODE    0x001
#define BMASK_SET     0x002
#define BMASK_UP      0x004
#define BMASK_ALM     0x008
#define BMASK_CHIME   0x010
#define BMASK_CVUP    0x020
#define BMASK_CVDN    0x040
#define BMASK_SOUND   0x080
#define BMASK_ALMSEL  0x100

// ── FreeRTOS task handle ──────────────────────────────────────────────────────
TaskHandle_t h_wifi_task = NULL;

// ── Pushover priority queue ────────────────────────────────────────────────────
//
// THE PROBLEM THIS FIXES: with only one pending slot, a high-frequency caller
// (courtyard PIR checks, run every loop() pass) could silently overwrite a
// Braai/Smoker notification that Core 0 hadn't sent yet — message lost with
// no error. This is why Braai turn reminders sometimes arrived 4-5 minutes
// late: the one that *did* arrive was actually a *later* event that won the
// race, not the original one delayed.
//
// THE FIX: a small fixed-size ring buffer holds several pending messages.
// Core 0's drain loop always sends the HIGHEST-PRIORITY pending message first
// (FIFO within the same priority level). This guarantees Panic/Intruder/Alarm
// (priority 1) NEVER sit behind Braai/Smoker (priority 0) chatter — they jump
// the queue every time. If the queue is ever full, we drop the OLDEST
// priority-0 message to make room — a priority-1 message is NEVER dropped to
// make space, and a priority-1 message NEVER gets evicted by anything.
//
// Core 1 (loop(), any web handler) calls po_notify() — same signature as
// before, nothing else in the firmware needs to change.

struct PoMsg {
  bool     used;
  uint8_t  priority;
  char     title[48];
  char     body[160];
  char     sound[24];
  uint16_t retry;    // Per-message priority-2 pacing
  uint16_t expire;
};
PoMsg        g_po_queue[PO_QUEUE_SIZE];
portMUX_TYPE g_po_mux = portMUX_INITIALIZER_UNLOCKED;

// Call from ANY core — writes notification into the queue and returns immediately
// sound: a Pushover built-in sound name (see https://pushover.net/api#sounds), or
// "" (default) to use the user's own chosen default tone.
void po_notify(const String& title, const String& msg, uint8_t pri, const String& sound, uint16_t retry, uint16_t expire) {
  portENTER_CRITICAL(&g_po_mux);

  // Find a free slot
  int slot = -1;
  for (int i = 0; i < PO_QUEUE_SIZE; i++) {
    if (!g_po_queue[i].used) { slot = i; break; }
  }

  // Queue full — make room WITHOUT EVER touching a priority-1 (alarm/panic)
  // message. Only ever evict the oldest priority-0 slot. If every slot is
  // priority-1 (should be essentially impossible in practice), the new
  // message is dropped rather than risk losing an alarm event — this is the
  // one case where silently dropping is the SAFER failure mode.
  if (slot == -1) {
    for (int i = 0; i < PO_QUEUE_SIZE; i++) {
      if (g_po_queue[i].priority == 0) { slot = i; break; }
    }
  }

  if (slot != -1) {
    g_po_queue[slot].used     = true;
    g_po_queue[slot].priority = pri;
    strncpy(g_po_queue[slot].title, title.c_str(), 47); g_po_queue[slot].title[47] = 0;
    strncpy(g_po_queue[slot].body,  msg.c_str(),  159); g_po_queue[slot].body[159] = 0;
    strncpy(g_po_queue[slot].sound, sound.c_str(), 23); g_po_queue[slot].sound[23] = 0;
    g_po_queue[slot].retry  = retry;   // G_po_queue[slot].expire = expire;
  } else {
    Serial.println("Pushover: queue full of priority-1 messages — dropped one (should not happen)");
  }

  portEXIT_CRITICAL(&g_po_mux);
}

// Call from Core 0 only — finds and claims the highest-priority pending
// message (FIFO within the same priority), copies it out, and frees the slot.
// Returns true if a message was found and copied into the out-params.
bool po_queue_pop(uint8_t& pri, String& title, String& body, String& sound, uint16_t& retry, uint16_t& expire) {
  portENTER_CRITICAL(&g_po_mux);
  int best = -1;
  for (int i = 0; i < PO_QUEUE_SIZE; i++) {
    if (g_po_queue[i].used) {
      if (best == -1 || g_po_queue[i].priority > g_po_queue[best].priority) {
        best = i;
      }
    }
  }
  bool found = (best != -1);
  if (found) {
    pri   = g_po_queue[best].priority;
    title = String(g_po_queue[best].title);
    body  = String(g_po_queue[best].body);
    sound = String(g_po_queue[best].sound);
    retry  = g_po_queue[best].retry;    // Expire = g_po_queue[best].expire;
    g_po_queue[best].used = false;
  }
  portEXIT_CRITICAL(&g_po_mux);
  return found;
}

// ── Thread-safe deferred beep request ─────────────────────────────────────────
// beep_single()/double()/triple() use tone()+delay() and block for 80-500ms.
// Calling them directly from a web handler (Core 0) stalls webServer.handleClient()
// for that long, delaying the HTTP response back to the phone/browser — this is
// what made Panic/Arm/Disarm feel slow or need repeat taps after WiFi sat idle.
// Fix: web handlers just set a request flag here (near-instant), and loop() on
// Core 1 does the actual beeping a few ms later.
enum BeepKind : uint8_t { BEEP_NONE = 0, BEEP_SINGLE, BEEP_DOUBLE, BEEP_TRIPLE };
volatile uint8_t g_beep_pending = BEEP_NONE;   // BeepKind value, or BEEP_NONE

// Call from ANY core (web handlers included) — returns immediately
void request_beep(uint8_t kind) {
  g_beep_pending = kind;   // last request wins; fine for a UI confirmation beep
}

/******************************************************************************
 * PREFERENCES — NVS (non-volatile) storage, replaces EEPROM
 ******************************************************************************/
// One shared Preferences object, reused across every subsystem's save/load
// functions. Each subsystem opens its OWN namespace (a short string, e.g.
// "pill", "med", "wekker", "course") via prefs.begin("namespace", readOnly)
// before reading or writing, and calls prefs.end() when done — so settings
// from different subsystems never collide, even though they all share this
// one object. Everything stored here survives a reboot, a power cut, and an
// OTA firmware update; nothing here needs the SD card or SPIFFS.
Preferences  prefs;

/******************************************************************************
 * FUNCTION PROTOTYPES
 ******************************************************************************/
void settings_save(void);
void settings_load(void);
void render(void);
void web_setup(void);
void rtc_sync(void);
void ntp_sync_to_rtc(void);
void inet_check(void);   // Bounded internet reachability probe
bool is_night_now(void);
void dfplayer_volume(uint8_t v);
void dfplayer_play(uint16_t t);
void dfplayer_stop(void);
void compose_bar3(void);
void leds_show_all(void);
void play_chime_with_vol(uint16_t track);
uint16_t chime_track_for_set(uint8_t ss, uint8_t q);
void update_brightness_smooth(void);
void splash_screen(void);
void check_factory_reset(void);
void factory_reset_defaults(void);
uint32_t smoke_elapsed_sec(void);
uint32_t braai_elapsed_sec(void);
uint32_t braai_remaining_sec(void);
String html_header(const char* title);
String html_footer(void);
void doc_save(void);
void doc_load(void);
void doc_purge_past(void);
void doc_check(void);
void doc_render_led(void);
void evt_save(void);       // Kalender events
void evt_load(void);
void evt_purge_past(void);
void evt_check(void);
void course_check_reset(uint8_t s);  // Kort Kursus (short course) — per slot
uint8_t course_due_dose(uint8_t s);
void adhoc_log(void);   // Ad-hoc extra dose log
void course_check(void);

// ── Security alarm forward declarations ──────────────────────────────────────
void sec_alarm_check_pir(void);
void sec_alarm_siren_update(void);
void sec_zone2_arm(void);
void sec_zone2_disarm(void);
void sec_full_disarm(void);
void sec_alarm_web_page(void);
void sec_panic(void);
void beep_single(void);
void beep_double(void);
void beep_triple(void);
void po_send(const String& title, const String& msg, uint8_t priority=0, const String& sound="", uint16_t retry=PO_RETRY_SECS, uint16_t expire=PO_EXPIRE_SECS);  // Pushover (Core 0 only)
void po_notify(const String& title, const String& msg, uint8_t pri = 0, const String& sound = "", uint16_t retry = PO_RETRY_SECS, uint16_t expire = PO_EXPIRE_SECS);  // Pushover (any core safe)
bool po_queue_pop(uint8_t& pri, String& title, String& body, String& sound, uint16_t& retry, uint16_t& expire);  // Pushover (Core 0 only)

/******************************************************************************
 * SETUP & MAIN LOOP
 * (all subsystem functions below are forward-declared above and implemented
 *  further down the file)
 ******************************************************************************/

/******************************************************************************
 * SETUP
 ******************************************************************************/
void setup(void) {
  Serial.begin(115200);
  delay(1000);   // give USB-serial enumeration a moment to settle after reset
  Serial.println();
  Serial.println("===== SETUP START =====");
  Serial.println(FIRMWARE_VERSION);

  // Button pins
  uint8_t pullup_btns[] = {BTN_MODE, BTN_SET, BTN_UP, BTN_ALM,
                            BTN_CHIME, BTN_CVUP, BTN_CVDN};
  for(uint8_t i = 0; i < 7; i++) pinMode(pullup_btns[i], INPUT_PULLUP);
  // GPIO34 & 35 = input-only, external 10K pullup required
  pinMode(BTN_SOUND,  INPUT);
  pinMode(BTN_ALMSEL, INPUT);
  pinMode(BTN_PILL,   INPUT_PULLUP);  // Ouma pill confirm button — also: hold 3s = WiFi/network reset
  pinMode(BTN_MED,    INPUT_PULLUP);  // Ouma medicine confirm button
  pinMode(BTN_BDAY,   INPUT_PULLUP);  // Birthday accept button

  // ── Security alarm pins ───────────────────────────────────────────────────
  // INPUT_PULLDOWN holds pins firmly LOW when no sensor connected (prevents
  // floating inputs from triggering false alarms during testing).
  // When real AM312 sensors are wired: their OUT pin actively drives HIGH/LOW
  // so the pulldown is simply overridden by the sensor — no change needed.
  if (PIR1_PIN != PIR_PARKED) pinMode(PIR1_PIN, INPUT_PULLDOWN);  // Parked, no GPIO
  pinMode(PIR2_PIN, INPUT_PULLDOWN);
  // GPIO36 and GPIO39 are input-only silicon — NO internal pulldown available
  // Wire a 10K resistor from each pin to GND on the PCB for those two
  // or leave floating — AM312 will drive them properly when connected
  pinMode(PIR5_PIN, INPUT_PULLDOWN);
  pinMode(SIREN_PIN, OUTPUT);
  digitalWrite(SIREN_PIN, LOW);  // make sure siren is off on boot

  // ── Boot lockout — prevents false Zone 1 alarm on power-up ───────────────
  // AM312 PIR sensors take 30-60 seconds to stabilise after power-on
  // Without lockout the floating or warm PIR output triggers Zone 1 immediately
  // Lockout gives 8 seconds for PIRs to settle before monitoring starts
  g_disarm_lockout_ms = millis();
  Serial.println("Boot lockout active — PIRs settling for 8 seconds...");
  Serial.println("[checkpoint] pins + lockout done");

  // FastLED
  FastLED.addLeds<LED_TYPE, WS_PIN, COLOR_ORDER>(leds, NUM_LEDS);
  FastLED.addLeds<LED_TYPE, BAR3_PIN, COLOR_ORDER>(bar3_leds, BAR3_NUM_LEDS);
  FastLED.setCorrection(TypicalLEDStrip);
  FastLED.setDither(0);
  // NOTE: this global brightness is effectively inert from here on — every
  // actual frame is pushed via leds_show_all()'s FastLED[0].showLeds(g_bright)
  // and FastLED[1].showLeds(g_bar3_bright), which scale each strip
  // independently. Left at a sane full-scale default just in case anything
  // ever calls FastLED.show() directly without going through leds_show_all().
  FastLED.setBrightness(255);
  FastLED.clear(true);
  Serial.println("[checkpoint] FastLED init done");

  // I2C — Wire uses GPIO21/22 by default on ESP32
  Wire.begin();
  Serial.println("[checkpoint] Wire.begin done");

  // DS3231 RTC
  if(!rtc.begin()) {
    Serial.println("DS3231 not found — check wiring!");
    // Flash red 5 times as error indicator
    for(uint8_t i = 0; i < 10; i++) {
      fill_solid(leds, NUM_LEDS, (i&1) ? CRGB::Black : CRGB(180,0,0));
      leds_show_all(); delay(200);
    }
  }
  if(rtc.lostPower()) {
    Serial.println("RTC lost power — time is not set. NTP will fix it.");
    rtc.adjust(DateTime(2025, 1, 1, 0, 0, 0));
  }
  Serial.println("[checkpoint] RTC init done");

  // Load settings FIRST — timezone and display preferences needed before rtc_sync
  settings_load();   // g_use_12hr and g_temp_degF both load from NVS, independently

  // Always boot in Celsius, regardless of what was last saved.
  // Reasoning: the long-press BTN_MODE shortcut (see ~line 3391) can silently
  // flip AND SAVE g_temp_degF with only a brief white LED flash as feedback —
  // easy to trigger by accident during normal use, easy to miss when it
  // happens. Rather than risk Ouma seeing °F after a power event (especially
  // during load-shedding, when Henry isn't there to fix it for her), every
  // boot now forces Celsius regardless of whatever was last saved. The
  // long-press shortcut still works during the session if ever needed —
  // it's just no longer persistent across a power cycle.
  g_temp_degF = false;
  pill_load();
  pill_check_reset();
#if !PILLS_ENABLED
  // Daily-pills retired — force the subsystem's existing "no pills"
  // mode regardless of what NVS says. Day strip + doctor LED keep working;
  // pill alarm can never fire; the /pills page that could re-enable it is
  // compiled out.
  g_pills_active = false;
  g_pill_alm_en  = false;
#endif
  med_load();
  med_check_reset();
  bday_load();
  doc_load();
  evt_load();    // Kalender events
  note_load();   // Notaboekie
  wekker_load();   // Wekkers restored from NVS after reboot
  Serial.println("[checkpoint] settings + pill/med/bday/doc/wekker load done");

  // Now sync RTC with correct timezone already loaded
  rtc_sync();
  Serial.println("[checkpoint] rtc_sync done");

  // BH1750 light sensor — auto brightness
  Wire.beginTransmission(0x23);
  uint8_t err23 = Wire.endTransmission();
  Wire.beginTransmission(0x5C);
  uint8_t err5C = Wire.endTransmission();
  if(err23 == 0) {
    lightMeter.begin(BH1750::CONTINUOUS_HIGH_RES_MODE, 0x23);
    Serial.println("BH1750 found at 0x23 — auto brightness active");
  } else if(err5C == 0) {
    lightMeter.begin(BH1750::CONTINUOUS_HIGH_RES_MODE, 0x5C);
    Serial.println("BH1750 found at 0x5C — auto brightness active");
  } else {
    Serial.println("BH1750 NOT found — check wiring!");
    lightMeter.begin(BH1750::CONTINUOUS_HIGH_RES_MODE, 0x23);
  }
  Serial.println("[checkpoint] BH1750 init done");

  // Factory reset check (hold SET+UP at boot)
  check_factory_reset();
  Serial.println("[checkpoint] factory reset check done");

  // Settings already loaded above — splash, DFPlayer, WiFi next

  // Splash
  splash_screen();
  Serial.println("[checkpoint] splash_screen done");

  // DFPlayer on UART2
  Serial2.begin(9600, SERIAL_8N1, DFP_RX_PIN, DFP_TX_PIN);
  delay(1500);
  Serial.println("[checkpoint] Serial2.begin + 1.5s settle done");

  // ── Explicitly select TF (SD) card as playback device ──────────────────────
  // CONFIRMED FIX: this clone DFPlayer module returns cmd=0x40 error
  // (param=0x7E) on every play command until told explicitly which device
  // to use, even though TF card is supposed to be the default. Standalone
  // testing on 2026-06-17 confirmed adding this resolves playback.
  // SAFETY: every flush/listen loop below is hard time-bounded — a noisy or
  // floating RX line (loose wire, bars not yet connected) could otherwise
  // make available() stay true forever and hang setup() before WiFi/loop()
  // ever start. Added 2026-06-21 after a real freeze traced to this risk.
  {
    uint32_t fs = millis();
    while(Serial2.available() && (millis() - fs < 50)) Serial2.read();
  }
  dfp_send(0x09, 0, 2);   // 2 = TF card
  delay(500);

  // ── DFPlayer diagnostic — query module, listen for reply ──────────────────
  Serial.println("--- DFPlayer diagnostic ---");
  {
    uint32_t fs = millis();
    while(Serial2.available() && (millis() - fs < 50)) Serial2.read();
  }
  dfp_send(0x3F, 0, 0);   // query online storage devices
  uint32_t dfp_wait_start = millis();
  bool dfp_responded = false;
  uint8_t dfp_buf[10]; uint8_t dfp_idx = 0;
  while(millis() - dfp_wait_start < 800) {
    uint32_t inner_start = millis();
    while(Serial2.available() && (millis() - inner_start < 50)) {
      uint8_t b = Serial2.read();
      if(dfp_idx == 0 && b != 0x7E) continue;
      if(dfp_idx < 10) dfp_buf[dfp_idx++] = b;
      if(dfp_idx == 10 && dfp_buf[9] == 0xEF) {
        dfp_responded = true;
        Serial.printf("DFPlayer replied: cmd=0x%02X param=0x%02X%02X\n",
                       dfp_buf[3], dfp_buf[5], dfp_buf[6]);
      }
    }
    if(dfp_responded) break;
  }
  if(!dfp_responded) {
    Serial.println("DFPlayer: NO RESPONSE — check RX/TX wiring, power, or SD card!");
  } else {
    Serial.println("DFPlayer: module is alive and responding to commands");
  }

  // ── NEW DIAGNOSTIC (2026-06-23) — ask the module directly how many files
  // its own internal index actually found on the card, separate from whether
  // Windows shows 27 files. This is command 0x48 in the DFPlayer protocol —
  // the reply's param (paramH/paramL as a 16-bit value) is the file count
  // the chip itself believes are playable. If this comes back as 2 (or any
  // number well under 27) while the PC confirms 27 valid files exist, that
  // proves the module's own directory walk is stopping early — a real,
  // hardware/firmware-internal indexing limitation, not a wiring or file
  // corruption problem.
  Serial.println("--- DFPlayer file count query (cmd 0x48) ---");
  {
    uint32_t fs = millis();
    while(Serial2.available() && (millis() - fs < 50)) Serial2.read();
  }
  dfp_send(0x48, 0, 2);   // 2 = query track count on TF card
  uint32_t count_wait_start = millis();
  bool count_responded = false;
  uint8_t cnt_buf[10]; uint8_t cnt_idx = 0;
  while(millis() - count_wait_start < 800) {
    uint32_t inner_start = millis();
    while(Serial2.available() && (millis() - inner_start < 50)) {
      uint8_t b = Serial2.read();
      if(cnt_idx == 0 && b != 0x7E) continue;
      if(cnt_idx < 10) cnt_buf[cnt_idx++] = b;
      if(cnt_idx == 10 && cnt_buf[9] == 0xEF) {
        count_responded = true;
        uint16_t file_count = ((uint16_t)cnt_buf[5] << 8) | cnt_buf[6];
        Serial.printf("DFPlayer reports %u file(s) found on card (expected 27)\n", file_count);
      }
    }
    if(count_responded) break;
  }
  if(!count_responded) {
    Serial.println("DFPlayer: file-count query got no reply (older firmware on the clone chip may not support cmd 0x48)");
  }
  Serial.println("---------------------------");
  g_dfp_alive = dfp_responded;   // shown permanently on free bar — no serial needed
  Serial.println("[checkpoint] DFPlayer diagnostic done");

  dfplayer_volume(g_vol);
  Serial.println("[checkpoint] dfplayer_volume set");

  // Start WiFi / NTP / OTA / Web on core 0 (Arduino loop runs on core 1)
#if ENABLE_WIFI
  xTaskCreatePinnedToCore(wifi_task, "wifi", 8192, NULL, 1, &h_wifi_task, 0);
  Serial.println("[checkpoint] wifi_task created on core 0");
#else
  Serial.println("*** ENABLE_WIFI=0 — WiFi/NTP/OTA/web portal DISABLED for this test ***");
#endif

  g_last_interaction_ms = millis();
  Serial.println("===== SETUP COMPLETE — entering loop() =====");
}

/******************************************************************************
 * MAIN LOOP — runs on Core 1 at full speed; WiFi/OTA/Pushover run on Core 0
 ******************************************************************************/
void loop(void) {
  uint32_t now_ms = millis();

  // OTA render-race guard. While an OTA update is
  // receiving, Core 0's progress callbacks own FastLED — everything below
  // (renders, button flashes, alarms) stands down until the update finishes
  // (device reboots) or fails (flag cleared in onError, life resumes).
  if (g_ota_active) { delay(50); return; }

  // ── DIAGNOSTIC: type a track number + Enter in Serial Monitor to play it ──
  // Uses the REAL dfplayer_play()/DFP_TRACK_MAP path — same code the clock
  // itself uses for chimes/alarms/egg timer — so this is a true like-for-like
  // test, just triggered manually instead of waiting for a scheduled event.
  // e.g. type 2 = egg alert, 10 = chime set0/q0, 61=pill, 62=med, 63=bday, 64=doc
  {
    static char serial_buf[6];
    static uint8_t serial_len = 0;
    while(Serial.available()) {
      char c = Serial.read();
      if(c >= '0' && c <= '9') {
        if(serial_len < 5) serial_buf[serial_len++] = c;
      } else if((c == '\n' || c == '\r') && serial_len > 0) {
        serial_buf[serial_len] = '\0';
        int track = atoi(serial_buf);
        serial_len = 0;
        Serial.printf(">>> Manual test: dfplayer_play(%d)\n", track);
        dfplayer_volume(g_vol);
        dfplayer_play((uint16_t)track);
      }
    }
  }

  timekeeping_update();

  // ── Security alarm — check PIRs and update siren (every loop pass) ────────
  sec_alarm_check_pir();
  sec_alarm_siren_update();

  // ── Deferred beep — runs the actual blocking tone() here on Core 1, never
  // inside a web handler on Core 0. Keeps HTTP responses (Panic, Arm, Disarm,
  // Zone 1 toggle) instant regardless of how "cold" the WiFi connection is.
  if(g_beep_pending != BEEP_NONE) {
    uint8_t kind = g_beep_pending;
    g_beep_pending = BEEP_NONE;
    if(kind == BEEP_SINGLE)      beep_single();
    else if(kind == BEEP_DOUBLE) beep_double();
    else if(kind == BEEP_TRIPLE) beep_triple();
  }

  // Chime (never while alarm fires)
  if(g_chime_req) {
    g_chime_req = false;
    if(!g_alm_fire) play_chime_with_vol(chime_track_for_set(g_sound_set, g_chime_track));
  }

  // Brightness update — called every loop; internal timers handle sensor read (100ms) and fade (20ms)
  update_brightness_smooth();

  // Button scan every 10ms
  if(now_ms - g_last_btn_ms >= 10) {
    g_last_btn_ms = now_ms;
    check_inputs();
  }

  // Pill button check every 20ms
  static uint32_t last_pill_ms = 0;
  if(now_ms - last_pill_ms >= 20) {
    last_pill_ms = now_ms;
    pill_check_button();
    pill_render();
    wifi_reset_check_button();   // GPIO2 held 3s = manual reboot (WiFi reconnect after loadshedding)
    med_check_button();
    med_render();
    bday_check_button();
    bday_render_leds();
    doc_render_led();
  }

  // Render every 100ms (10fps is smooth enough for a clock)
  // OR immediately if g_force_redraw was set (e.g. web dismiss) — avoids stuck dark frame
  static uint32_t last_render_ms = 0;
  if(now_ms - last_render_ms >= 100 || g_force_redraw) {
    last_render_ms = now_ms;
    g_force_redraw = false;
    render();
  }

  // Auto-stop the wake/clock alarm after 3 minutes if nobody dismissed it
  // (power-saving when away — speaker + bar LED already did their job by then)
  if(g_alm_fire && !g_wekker_ringing && (now_ms - g_alm_fire_ms >= 180000UL)) {
    g_alm_fire = false;
    dfplayer_stop();
    Serial.println("Wake alarm auto-stopped after 3 minutes (not dismissed)");
  }

  // Re-loop DFPlayer alarm every 30s while alarm fires
  // (checks !g_wekker_ringing so Alarm's re-loop never fires while Wekkers
  // is the one actually ringing — they share g_alm_fire for status/chime
  // purposes, but each has its own repeat logic)
  static uint32_t alm_loop_ms = 0;
  if(g_alm_fire && !g_wekker_ringing && (now_ms - alm_loop_ms >= 30000)) {
    alm_loop_ms = now_ms;
    dfplayer_volume(g_alarm_vol);
    dfplayer_play(1);
  }
  if(!g_alm_fire) alm_loop_ms = now_ms;

  // ── Wekkers repeat-until-accepted ─────────────────────────────────────────
  // Repeats every WEKKER_REPEAT_MS, up to WEKKER_MAX_REPEATS times, or stops
  // immediately if BTN_BDAY (accept) was pressed (handled in
  // bday_check_button(), which clears g_wekker_ringing directly).
  if(g_wekker_ringing) {
    if(g_wekker_repeat_count >= WEKKER_MAX_REPEATS) {
      g_wekker_ringing = false;
      g_alm_fire       = false;
      Serial.println("[wekker] gave up after max repeats, not accepted");
    } else if(now_ms - g_wekker_last_play_ms >= WEKKER_REPEAT_MS) {
      g_wekker_last_play_ms = now_ms;
      g_wekker_repeat_count++;
      Serial.printf("[wekker] repeat %d/%d\n", g_wekker_repeat_count, WEKKER_MAX_REPEATS);
      dfplayer_volume(g_alarm_vol);
      dfplayer_play(2);
    }
  }
}

/******************************************************************************
 * SUBSYSTEMS
 ******************************************************************************/

/******************************************************************************
 * Pill Reminder Functions
 ******************************************************************************/

// Save pill status to NVS (survives power cuts)
void pill_save(void) {
  prefs.begin("pill", false);
  prefs.putBool ("taken",    g_pill_taken);
  prefs.putUChar("lastday",  g_pill_last_day);
  prefs.putUChar("almhh",    g_pill_alm_hh);
  prefs.putUChar("almmm",    g_pill_alm_mm);
  prefs.putBool ("almen",    g_pill_alm_en);
  prefs.putBool ("active",   g_pills_active);
  prefs.end();
}

// Load pill status from NVS
void pill_load(void) {
  prefs.begin("pill", true);
  g_pill_taken    = prefs.getBool ("taken",   false);
  g_pill_last_day = prefs.getUChar("lastday", 255);
  g_pill_alm_hh   = prefs.getUChar("almhh",  8);
  g_pill_alm_mm   = prefs.getUChar("almmm",  0);
  g_pill_alm_en   = prefs.getBool ("almen",  true);
  g_pills_active  = prefs.getBool ("active", true);
  prefs.end();
}

// Check if pill status needs resetting (new day)
void pill_check_reset(void) {
  uint8_t today = (rtc_dow() + 6) % 7;  // Monday=0 ... Sunday=6
  if (today != g_pill_last_day) {
    // New day — reset pill status
    g_pill_taken    = false;
    g_pill_last_day = today;
    g_pill_alm_fire = false;
    pill_save();
    Serial.println("Pill status reset for new day");
  }
}

// Ouma confirmed she took her pills
void pill_confirm(void) {
  g_pill_taken    = true;
  g_pill_alm_fire = false;
  g_pill_last_day = (rtc_dow() + 6) % 7;
  pill_save();
  // Play confirmation sound on DFPlayer
  dfplayer_volume(is_night_now() ? g_night_vol : g_vol);
  dfplayer_play(PILL_TRACK); voice_lock();
  Serial.println("Pills confirmed taken!");
}

// Render the Sunlephant 7-day LED strip
void pill_render(void) {
  uint8_t today   = (rtc_dow() + 6) % 7;  // Monday=0 ... Sunday=6
  uint8_t bright  = is_night_now() ? 30 : 120;

  for (uint8_t i = 0; i < PILL_NUM_LEDS; i++) {
    if (i == 7) {
      // LED 7 controlled by doc_render_led() — skip here
      continue;
    }

    if (g_pill_alm_fire) {
      // Pill alarm firing — pulse all orange
      uint8_t pulse = (uint8_t)(128 + 127 * sin(millis() / 400.0));
      pill_leds[i] = CRGB(pulse, pulse / 3, 0);
      continue;
    }

    if (i == today) {
      // Today
      if (!g_pills_active) {
        // No pills to take today — soft green pulse = geen medikasie
        uint8_t pulse = (uint8_t)(25 + 15 * sin(millis() / 1200.0));
        pill_leds[i] = CRGB(0, pulse, 0);
      } else if (g_pill_taken) {
        pill_leds[i] = CRGB(0, bright, 0);        // GREEN = taken
      } else {
        // Red pulse to draw attention
        uint8_t pulse = (uint8_t)(80 + 80 * sin(millis() / 600.0));
        pill_leds[i] = CRGB(pulse, 0, 0);          // RED pulsing = not taken
      }
    } else if (i < today) {
      // Past days this week
      uint8_t dim = bright / 2;
      pill_leds[i] = CRGB(dim, dim, dim);           // dim white = past
    } else {
      // Future days
      pill_leds[i] = CRGB::Black;                   // off = future
    }
  }
  leds_show_all();  // shows both leds[] and pill_leds[] together
}

// Check pill button (GPIO2) — debounced
void pill_check_button(void) {
#if !PILLS_ENABLED
  return;  // Daily-pills retired — button inert, kept wired for future use
#endif
  bool btn_now = (digitalRead(BTN_PILL) == LOW);
  if (btn_now && !g_pill_btn_prev) {
    // Rising edge — button just pressed
    if (!g_pill_taken) {
      pill_confirm();
    } else {
      // Already taken — flash green quickly as acknowledgement
      for (uint8_t f = 0; f < 3; f++) {
        fill_solid(pill_leds, PILL_NUM_LEDS, CRGB(0, 120, 0));
        leds_show_all(); delay(100);
        fill_solid(pill_leds, PILL_NUM_LEDS, CRGB::Black);
        leds_show_all(); delay(100);
      }
    }
    g_last_interaction_ms = millis();
  }
  g_pill_btn_prev = btn_now;
}

// Check WiFi/network reset button — repurposed GPIO2 (BTN_PILL, Blue,
// Sw10) since the daily-pills subsystem was retired (PILLS_ENABLED 0) and
// left this button permanently inert. NEW: Loadshedding fix, Henry's
// request — when the router/ONT is still coming back up after power is
// restored, WiFiManager's one-shot autoConnect() in wifi_task() can fail
// (SSID not broadcasting yet) and the clock then just runs offline until
// someone power-cycles it. Rather than needing to unplug/replug, HOLD this
// button for 3 seconds to reboot the clock in place — on the next boot,
// autoConnect() tries again and normally succeeds once the router is up.
// Held (not a single tap) on purpose so a stray knock never triggers a
// reboot. Works identically whether or not the web portal is reachable —
// it's a physical button, not a network request.

void wifi_reset_check_button(void) {
  bool btn_now = (digitalRead(BTN_PILL) == LOW);   // shared pin with BTN_PILL

  if (btn_now && !g_wifi_btn_prev) {
    // Rising edge — press started
    g_wifi_btn_down_ms = millis();
    g_wifi_btn_fired    = false;
  }

  if (btn_now && g_wifi_btn_down_ms != 0 && !g_wifi_btn_fired) {
    uint32_t held_ms = millis() - g_wifi_btn_down_ms;

    // Feedback while holding: pulse the internet-reachability LED [27] red
    // faster the longer it's held, so there's visible confirmation the
    // press has been registered well before the 3s trigger.
    bar3_leds[FREE_BASE + 7] = ((millis() / 150) % 2 == 0) ? CRGB(200, 0, 0) : CRGB::Black;

    if (held_ms >= WIFI_BTN_HOLD_MS) {
      g_wifi_btn_fired = true;
      Serial.println("BTN_PILL held 3s — manual WiFi/network reset requested, restarting...");
      // Quick solid-red flash on the whole free/status bar as a clear
      // "restarting now" cue before the reboot cuts the LEDs off anyway.
      for (uint8_t f = 0; f < 3; f++) {
        bar3_leds[FREE_BASE + 7] = CRGB(255, 0, 0);
        leds_show_all(); delay(120);
        bar3_leds[FREE_BASE + 7] = CRGB::Black;
        leds_show_all(); delay(120);
      }
      delay(200);
      ESP.restart();
    }
  }

  if (!btn_now && g_wifi_btn_prev) {
    // Released before reaching the 3s hold threshold: this was a short tap,
    // not a WiFi-reset request. Use it for a "quick peek" at the smoker's
    // elapsed time on the main display (Henry's request) — only if the
    // smoker is actually running, otherwise there's nothing worth showing.
    if (!g_wifi_btn_fired && g_smoke_running) {
      g_smoke_peek_active = true;
      g_smoke_peek_end_ms = millis() + SMOKE_PEEK_MS;
    }
    g_wifi_btn_down_ms = 0;
    g_wifi_btn_fired    = false;
  }

  g_wifi_btn_prev = btn_now;
}

// Check if pill reminder alarm should fire
void pill_check_alarm(void) {
  if (!g_pill_alm_en)    return;   // alarm disabled
  if (!g_pills_active)   return;   // no pills today
  if (g_pill_taken)      return;   // already taken today
  if (g_pill_alm_fire)   return;   // already firing

  if (g_hh == g_pill_alm_hh && g_mm == g_pill_alm_mm && g_new_minute) {  // was && g_ss == 0
    g_pill_alm_fire = true;
    dfplayer_volume(is_night_now() ? g_night_vol : g_vol);
    dfplayer_play(PILL_TRACK); voice_lock();
    Serial.println("Pill reminder alarm fired!");
  }
}


/******************************************************************************
 * Medicine Schedule Functions
 ******************************************************************************/

void med_save(void) {
  prefs.begin("med", false);
  prefs.putUChar("doses", g_med_doses);
  prefs.putUChar("lastday", g_med_last_day);
  // Kort Kursus — TWO independent slots, keys prefixed "c<slot>..."
  for (uint8_t s = 0; s < COURSE_SLOTS; s++) {
    String p = "c" + String(s);   // key prefix per slot, e.g. "c0name", "c1total"
    prefs.putString((p + "name").c_str(),  g_course[s].name);
    prefs.putUChar (("c" + String(s) + "d").c_str(), g_course[s].doses);
    prefs.putUChar ((p + "total").c_str(), g_course[s].days_total);
    prefs.putUChar ((p + "left").c_str(),  g_course[s].days_left);
    prefs.putUChar ((p + "lday").c_str(),  g_course[s].last_day);
    for (uint8_t i = 0; i < COURSE_MAX_DOSES; i++) {
      String k = p + String(i);
      prefs.putUChar(("h" + k).c_str(), g_course[s].hh[i]);
      prefs.putUChar(("m" + k).c_str(), g_course[s].mm[i]);
      prefs.putBool (("t" + k).c_str(), g_course[s].taken[i]);
    }
  }
  // Ad-hoc unscheduled extra-dose log
  prefs.putUChar ("adhcnt", g_adhoc_count);
  prefs.putUChar ("adhlday", g_adhoc_last_day);
  for (uint8_t i = 0; i < ADHOC_MAX_LOG; i++) {
    String k = String(i);
    prefs.putUChar(("ahh" + k).c_str(), g_adhoc_hh[i]);
    prefs.putUChar(("amm" + k).c_str(), g_adhoc_mm[i]);
  }
  for (uint8_t i = 0; i < MED_MAX_DOSES; i++) {
    String k = String(i);
    prefs.putUChar(("hh" + k).c_str(), g_med[i].hh);
    prefs.putUChar(("mm" + k).c_str(), g_med[i].mm);
    prefs.putBool (("tk" + k).c_str(), g_med[i].taken);
  }
  prefs.end();
}

void med_load(void) {
  prefs.begin("med", true);
  uint8_t d = prefs.getUChar("doses", 2);
  if (d <= MED_MAX_DOSES) g_med_doses = d;
  g_med_last_day      = prefs.getUChar("lastday",   255);
  // Kort Kursus — TWO independent slots
  for (uint8_t s = 0; s < COURSE_SLOTS; s++) {
    String p = "c" + String(s);
    String cname = prefs.getString((p + "name").c_str(), "");
    strncpy(g_course[s].name, cname.c_str(), sizeof(g_course[s].name) - 1);
    g_course[s].name[sizeof(g_course[s].name) - 1] = '\0';
    g_course[s].doses = prefs.getUChar(("c" + String(s) + "d").c_str(), 0);
    if (g_course[s].doses > COURSE_MAX_DOSES) g_course[s].doses = COURSE_MAX_DOSES;
    g_course[s].days_total = prefs.getUChar((p + "total").c_str(), 0);
    g_course[s].days_left  = prefs.getUChar((p + "left").c_str(),  0);
    g_course[s].last_day   = prefs.getUChar((p + "lday").c_str(),  255);
    for (uint8_t i = 0; i < COURSE_MAX_DOSES; i++) {
      String k = p + String(i);
      uint8_t chh = prefs.getUChar(("h" + k).c_str(), g_course[s].hh[i]);
      uint8_t cmm = prefs.getUChar(("m" + k).c_str(), g_course[s].mm[i]);
      if (chh < 24) g_course[s].hh[i] = chh;
      if (cmm < 60) g_course[s].mm[i] = cmm;
      g_course[s].taken[i] = prefs.getBool(("t" + k).c_str(), false);
    }
  }
  // Ad-hoc unscheduled extra-dose log
  g_adhoc_count    = prefs.getUChar("adhcnt",  0);
  if (g_adhoc_count > ADHOC_MAX_LOG) g_adhoc_count = ADHOC_MAX_LOG;
  g_adhoc_last_day = prefs.getUChar("adhlday", 255);
  for (uint8_t i = 0; i < ADHOC_MAX_LOG; i++) {
    String k = String(i);
    g_adhoc_hh[i] = prefs.getUChar(("ahh" + k).c_str(), 0);
    g_adhoc_mm[i] = prefs.getUChar(("amm" + k).c_str(), 0);
  }
  for (uint8_t i = 0; i < MED_MAX_DOSES; i++) {
    String k = String(i);
    uint8_t hh = prefs.getUChar(("hh" + k).c_str(), g_med[i].hh);
    uint8_t mm = prefs.getUChar(("mm" + k).c_str(), g_med[i].mm);
    if (hh < 24) g_med[i].hh = hh;
    if (mm < 60) g_med[i].mm = mm;
    g_med[i].taken = prefs.getBool(("tk" + k).c_str(), false);
  }
  prefs.end();
}

// Reset all doses at midnight / new day
void med_check_reset(void) {
  uint8_t today = (rtc_dow() + 6) % 7;  // Monday=0 ... Sunday=6
  if (today != g_med_last_day) {
    for (uint8_t i = 0; i < MED_MAX_DOSES; i++) g_med[i].taken = false;
    g_med_last_day      = today;
    g_med_alm_active    = 255;
    med_save();
    Serial.println("Medicine doses reset for new day");
  }
  // Ad-hoc extra-dose log resets independently (own day detector, same
  // pattern) — keeps this fully separate from the chronic reset above so a
  // future change to one can't silently affect the other.
  if (today != g_adhoc_last_day) {
    g_adhoc_count    = 0;
    g_adhoc_last_day = today;
    med_save();
  }
}

// ── Kort Kursus (Short Course) day rollover ─────────────
// Uses g_day (day-of-month), NOT day-of-week like med_check_reset() above —
// a course must count REAL elapsed calendar days (4 means 4, not "any day
// that differs from last time mod 7"). Same new-day pattern as
// evt_check()/doc_check(). Now takes a slot index — each of the two course
// slots rolls over and finishes completely independently, so Ria's two
// antibiotics on two different day-counts don't interfere with each other.
void course_check_reset(uint8_t s) {
  Course& c = g_course[s];
  if (c.doses == 0 || c.days_left == 0) return;   // this slot has no active course
  if (g_day == c.last_day) return;                 // same day, nothing to do
  c.last_day = g_day;
  c.days_left--;
  if (c.days_left == 0) {
    // Course finished — clear it automatically, no manual switch-off needed
    po_notify("Kort Kursus klaar / Course finished",
      String(c.name) + " is nou klaar. / course is now complete.\nTyd: " + po_time(), 0);
    c.doses = 0;
    c.name[0] = '\0';
    med_save();
    Serial.println("Kort Kursus slot " + String(s) + " finished and cleared");
    return;
  }
  for (uint8_t i = 0; i < c.doses; i++) c.taken[i] = false;
  if (g_course_alm_slot == s) { g_course_alm_slot = 255; g_course_alm_dose = 255; }
  med_save();
  Serial.println("Kort Kursus slot " + String(s) + " rolled to next day");
}

// Log an unscheduled extra dose RIGHT NOW . No time to
// set, no course to configure: just records that it happened, for today's
// record and for the family's peace of mind. FYI Pushover only (priority 0,
// no acknowledge needed) since this reports something already done, not a
// reminder to do something.
void adhoc_log(void) {
  if (g_adhoc_count >= ADHOC_MAX_LOG) return;   // 6/day is already a lot — quietly ignore further taps
  g_adhoc_hh[g_adhoc_count] = g_hh;
  g_adhoc_mm[g_adhoc_count] = g_mm;
  g_adhoc_count++;
  med_save();
  dfplayer_volume(is_night_now() ? g_night_vol : g_vol);
  dfplayer_play(MED_TRACK); voice_lock();
  char hhmm[6]; snprintf(hhmm, sizeof(hhmm), "%02u:%02u", g_hh, g_mm);
  po_notify("Ekstra Medisyne / Extra Medicine",
    "Ouma het 'n ekstra dosis geneem om " + String(hhmm) + ".\nTyd: " + po_time(), 0);
  Serial.print("Ad-hoc extra dose logged at "); Serial.println(hhmm);
}

// Find the next due-but-not-taken dose WITHIN a given course slot (255=none)
uint8_t course_due_dose(uint8_t s) {
  Course& c = g_course[s];
  if (c.doses == 0 || c.days_left == 0) return 255;
  for (uint8_t i = 0; i < c.doses; i++) {
    if (!c.taken[i] &&
        (g_hh > c.hh[i] || (g_hh == c.hh[i] && g_mm >= c.mm[i]))) {
      return i;
    }
  }
  return 255;
}

// ── Kort Kursus per-second check — fires voice/LED at dose time + Pushover ──
// pre-warning MED_PO_LEAD_MIN minutes ahead, same acknowledge-or-keep-nagging
// pattern as the chronic medicine Pushover. loops BOTH slots,
// completely independently — two courses can fire, pre-warn, and finish on
// their own separate schedules without ever touching each other's state.
// Notification text always names the course, so two simultaneous alerts are
// never ambiguous about which medicine they're about.
void course_check(void) {
  for (uint8_t s = 0; s < COURSE_SLOTS; s++) {
    course_check_reset(s);
    Course& c = g_course[s];
    if (c.doses == 0 || c.days_left == 0) continue;

#if MED_PUSHOVER
    if (g_new_minute) {
      for (uint8_t i = 0; i < c.doses; i++) {
        if (c.taken[i]) continue;
        int16_t warn = (int16_t)c.hh[i] * 60 + c.mm[i] - MED_PO_LEAD_MIN;
        if (warn < 0) warn += 24 * 60;
        if ((int16_t)g_hh * 60 + g_mm == warn) {
          char hhmm[6]; snprintf(hhmm, sizeof(hhmm), "%02u:%02u", c.hh[i], c.mm[i]);
          uint8_t day_num = c.days_total - c.days_left + 1;
          po_notify("Kort Kursus — " + String(c.name),
            "Oor " + String(MED_PO_LEAD_MIN) + " minute (om " + String(hhmm) + "): dosis " +
            String(i + 1) + " van " + String(c.doses) + ".\n" +
            "Dag " + String(day_num) + " van " + String(c.days_total) + ".\n" +
            "Druk Acknowledge sodra dit geneem is.\nTyd: " + po_time(),
            2, "", MED_PO_RETRY_SECS, MED_PO_EXPIRE_SECS);
        }
      }
    }
#endif

    for (uint8_t i = 0; i < c.doses; i++) {
      if (!c.taken[i] && g_hh == c.hh[i] && g_mm == c.mm[i] && g_new_minute) {
        g_course_alm_slot = s;
        g_course_alm_dose = i;
        dfplayer_volume(is_night_now() ? g_night_vol : g_vol);
        dfplayer_play(MED_TRACK); voice_lock();
        Serial.println("Kort Kursus slot " + String(s) + " dose alarm fired: " + String(i + 1));
        break;
      }
    }
  }
}

// Find the NEXT dose that is due but not yet taken
// Returns 255 if none due right now
uint8_t med_due_dose(void) {
  if (g_med_doses == 0) return 255;           // no script
  if (g_hh < MED_START_HH) return 255;        // before 07:00
  if (g_hh > MED_END_HH)   return 255;        // after 19:00
  for (uint8_t i = 0; i < g_med_doses; i++) {
    if (!g_med[i].taken) {
      // Is this dose time reached?
      if (g_hh > g_med[i].hh ||
         (g_hh == g_med[i].hh && g_mm >= g_med[i].mm)) {
        return i;
      }
    }
  }
  return 255;
}

// Confirm the current due dose taken
void med_confirm(void) {
  uint8_t due = med_due_dose();
  if (due == 255) {
    // No scheduled chronic dose due right now — check both Kort Kursus slots.
    // Two independent courses can both have doses due; slot 0 is
    // checked first. If both are due at once, this press resolves slot 0 —
    // pressing again immediately after resolves slot 1, same as how the
    // chronic medicine loop already resolves one dose per press.
    for (uint8_t s = 0; s < COURSE_SLOTS; s++) {
      uint8_t cdue = course_due_dose(s);
      if (cdue != 255) {
        g_course[s].taken[cdue] = true;
        if (g_course_alm_slot == s) { g_course_alm_slot = 255; g_course_alm_dose = 255; }
        med_save();
        dfplayer_volume(is_night_now() ? g_night_vol : g_vol);
        dfplayer_play(MED_TRACK); voice_lock();
        Serial.println("Kort Kursus slot " + String(s) + " dose confirmed taken: " + String(cdue + 1));
        return;
      }
    }
    // Nothing due at all — flash white briefly
    for (uint8_t f = 0; f < 2; f++) {
      fill_solid(med_leds, MED_NUM_LEDS, CRGB(60,60,60));
      leds_show_all(); delay(150);
      fill_solid(med_leds, MED_NUM_LEDS, CRGB::Black);
      leds_show_all(); delay(150);
    }
    return;
  }
  g_med[due].taken    = true;
  g_med_alm_active    = 255;
  med_save();
  dfplayer_volume(is_night_now() ? g_night_vol : g_vol);
  dfplayer_play(MED_TRACK); voice_lock();
  Serial.print("Medicine dose confirmed: "); Serial.println(due + 1);
}

// Check if any dose alarm should fire
void med_check_alarms(void) {
  if (g_med_doses == 0) return;
  if (g_hh < MED_START_HH || g_hh > MED_END_HH) return;
#if MED_PUSHOVER
  // Ouma's request: the phone warning now goes out
  // MED_PO_LEAD_MIN minutes BEFORE each dose (06:55 for a 07:00 dose), so
  // the pille are in hand by the time the clock announces. Emergency
  // priority as before — re-alerts every 5 min for up to 30 min until
  // Acknowledged, which comfortably spans the pre-warning AND the dose time.
  // Skipped if the dose was already confirmed taken by warn time. Minute
  // math wraps midnight correctly, though the 07:00-19:00 med window makes
  // that academic.
  if (g_new_minute) {
    for (uint8_t i = 0; i < g_med_doses; i++) {
      if (g_med[i].taken) continue;
      int16_t warn = (int16_t)g_med[i].hh * 60 + g_med[i].mm - MED_PO_LEAD_MIN;
      if (warn < 0) warn += 24 * 60;
      if ((int16_t)g_hh * 60 + g_mm == warn) {
        char hhmm[6]; snprintf(hhmm, sizeof(hhmm), "%02u:%02u", g_med[i].hh, g_med[i].mm);
        po_notify("Medisyne — Ouma",
          "Oor " + String(MED_PO_LEAD_MIN) + " minute (om " + String(hhmm) + "): dosis " +
          String(i + 1) + " van " + String(g_med_doses) + ".\n"
          "Druk Acknowledge sodra dit geneem is.\nTyd: " + po_time(),
          2, "", MED_PO_RETRY_SECS, MED_PO_EXPIRE_SECS);
      }
    }
  }
#endif

  for (uint8_t i = 0; i < g_med_doses; i++) {
    if (!g_med[i].taken &&
        g_hh == g_med[i].hh &&
        g_mm == g_med[i].mm &&
        g_new_minute) {   // was g_ss == 0 — a skipped second no longer skips the dose alarm
      g_med_alm_active = i;
      dfplayer_volume(is_night_now() ? g_night_vol : g_vol);
      dfplayer_play(MED_TRACK); voice_lock();
      Serial.print("Medicine alarm fired: dose "); Serial.println(i + 1);
      // Pushover MOVED to the 5-min pre-warning block above (Ouma's
      // request) — at the dose minute the clock does voice + LED only.
      break;
    }
  }
}

// Render the medicine LED strip
void med_render(void) {
  if (g_med_doses == 0) {
    // No active script — show one dim green LED to indicate "geen medikasie"
    // This way Ouma sees green = all good, not a scary blank strip
    fill_solid(med_leds, MED_NUM_LEDS, CRGB::Black);
    // Light LED 0 with a soft green pulse = "geen medikasie vir vandag"
    uint8_t pulse = (uint8_t)(30 + 20 * sin(millis() / 1200.0));
    med_leds[0] = CRGB(0, pulse, 0);
    leds_show_all();
    return;
  }

  uint8_t bright = is_night_now() ? 20 : 110;

  for (uint8_t i = 0; i < MED_NUM_LEDS; i++) {
    if (i >= g_med_doses) {
      // FIX 5 (2026-07-03): LEDs 4/5/6 belong to bday_render_leds(). This
      // blanking ran every 20ms and pushed the dark frame to the strip via
      // leds_show_all() below, BEFORE bday_render_leds() repainted them —
      // so the physical birthday LEDs alternated dark/lit frame after frame,
      // showing at roughly half brightness with visible flicker.
      if (i == BDAY_LED_3 || i == BDAY_LED_2 || i == BDAY_LED_1) continue;
      // Unused dose slot — off
      med_leds[i] = CRGB::Black;
      continue;
    }

    // Is this dose alarming right now?
    if (i == g_med_alm_active) {
      // Pulse orange — medicine time!
      uint8_t pulse = (uint8_t)(80 + 80 * sin(millis() / 350.0));
      med_leds[i] = CRGB(pulse, pulse / 4, 0);
      continue;
    }

    if (g_med[i].taken) {
      // GREEN = taken
      med_leds[i] = CRGB(0, bright, 0);
    } else {
      // Has this dose time passed without being taken?
      bool overdue = (g_hh > g_med[i].hh ||
                     (g_hh == g_med[i].hh && g_mm > g_med[i].mm));
      if (overdue) {
        // Pulse RED = overdue!
        uint8_t pulse = (uint8_t)(60 + 60 * sin(millis() / 500.0));
        med_leds[i] = CRGB(pulse, 0, 0);
      } else {
        // Future dose — dim blue
        uint8_t dim = bright / 2;
        med_leds[i] = CRGB(0, 0, dim);
      }
    }
  }

  // ── LED 7 = Kort Kursus (Short Course) indicator ────────
  // Only ONE physical LED for TWO possible independent courses (no spare LED
  // on this strip without stealing from the birthday indicators) — so this
  // shows the AGGREGATE across both slots: red pulse if EITHER slot has an
  // overdue dose (needs attention now), green only once ALL doses in ALL
  // active slots are taken, dim blue if on track but more doses are still
  // ahead today. Which course specifically needs attention is always spelled
  // out on the /medicine page and in the Pushover notification text.
  {
    bool any_active = false, all_taken = true, any_overdue = false;
    for (uint8_t s = 0; s < COURSE_SLOTS; s++) {
      Course& c = g_course[s];
      if (c.doses == 0 || c.days_left == 0) continue;
      any_active = true;
      for (uint8_t i = 0; i < c.doses; i++) {
        if (!c.taken[i]) {
          all_taken = false;
          if (g_hh > c.hh[i] || (g_hh == c.hh[i] && g_mm >= c.mm[i])) any_overdue = true;
        }
      }
    }
    if (!any_active) {
      med_leds[7] = CRGB::Black;
    } else if (all_taken) {
      med_leds[7] = CRGB(0, bright, 0);
    } else if (any_overdue) {
      bool flash_on = ((millis() / 500) % 2 == 0);
      med_leds[7] = flash_on ? CRGB(bright, 0, 0) : CRGB::Black;
    } else {
      med_leds[7] = CRGB(0, 0, bright / 2);   // taken so far, next dose still ahead today
    }
  }

  leds_show_all();
}

// Check medicine button (GPIO18) — debounced
void med_check_button(void) {
  bool btn_now = (digitalRead(BTN_MED) == LOW);
  if (btn_now && !g_med_btn_prev) {
    med_confirm();
    g_last_interaction_ms = millis();
  }
  g_med_btn_prev = btn_now;
}

// ── Wekkers NVS persistence ───────────────────────────────────────────────
// Every reboot (OTA, loadshedding, brownout) survives correctly — all three
// Wekkers reload their saved time/enabled/day-mask state, same save/load
// pattern as every other subsystem. g_wekker_fired_today[] is deliberately
// NOT saved — after a reboot the safe assumption is "not fired yet today",
// so a Wekker later the same day still rings rather than being silently
// skipped.
void wekker_save(void) {
  prefs.begin("wekker", false);
  for (uint8_t i = 0; i < NUM_ALARM_SLOTS; i++) {
    String k = String(i);
    prefs.putBool (("en" + k).c_str(), g_wekker_enabled[i]);
    prefs.putUChar(("hh" + k).c_str(), g_wekker_hh[i]);
    prefs.putUChar(("mm" + k).c_str(), g_wekker_mm[i]);
    prefs.putUChar(("dy" + k).c_str(), g_wekker_days[i]);
  }
  prefs.end();
}

void wekker_load(void) {
  prefs.begin("wekker", true);
  for (uint8_t i = 0; i < NUM_ALARM_SLOTS; i++) {
    String k = String(i);
    g_wekker_enabled[i] = prefs.getBool(("en" + k).c_str(), g_wekker_enabled[i]);
    uint8_t hh = prefs.getUChar(("hh" + k).c_str(), g_wekker_hh[i]);
    uint8_t mm = prefs.getUChar(("mm" + k).c_str(), g_wekker_mm[i]);
    uint8_t dy = prefs.getUChar(("dy" + k).c_str(), g_wekker_days[i]);
    if (hh < 24) g_wekker_hh[i] = hh;
    if (mm < 60) g_wekker_mm[i] = mm;
    g_wekker_days[i] = dy ? dy : 0x7F;   // never allow an all-zero day mask
  }
  prefs.end();
}

void settings_save(void) {
  prefs.begin("clock", false);
  prefs.putUChar("alm0hh",  g_alarm1.hh);
  prefs.putUChar("alm0mm",  g_alarm1.mm);
  prefs.putBool ("alm0en",  g_alarm1.enabled);
  prefs.putUChar("vol",     g_vol);
  prefs.putUChar("nvol",    g_night_vol);
  prefs.putUChar("avol",    g_alarm_vol);
  prefs.putUChar("brday",   g_bright_day);
  prefs.putUChar("brnight", g_bright_night);
  prefs.putBool ("chime",   g_chime_en);
  prefs.putUChar("eggmm",   g_egg_set_mm);
  prefs.putUChar("eggss",   g_egg_set_ss);
  prefs.putUChar("sndset",  g_sound_set);
  prefs.putBool ("hr12",    g_use_12hr);
  prefs.putBool ("tempF",   g_temp_degF);
  prefs.putShort("tz",      (int16_t)g_tz_offset_hours);
  prefs.putBool ("smkrun",  g_smoke_running);
  prefs.putBool ("smkpaus", g_smoke_paused);
  prefs.putULong("smkstart",g_smoke_start_unix);
  prefs.putULong("smkpu",   g_smoke_pause_unix);
  prefs.putULong("smkacc",  g_smoke_paused_accum);
  prefs.putString("smknote",g_smoke_note);
  prefs.putBool ("brEn",    g_braai_enabled);
  prefs.putBool ("brRun",   g_braai_running);
  prefs.putBool ("brPaus",  g_braai_paused);
  prefs.putULong("brStart", g_braai_start_unix);
  prefs.putULong("brPu",    g_braai_pause_unix);
  prefs.putULong("brAcc",   g_braai_paused_accum);
  prefs.putUShort("brTotal",g_braai_total_sec);
  prefs.putUShort("brTurn", g_braai_turn_sec);
  prefs.end();
}

void settings_load(void) {
  prefs.begin("clock", true);
  uint8_t v;
  v = prefs.getUChar("alm0hh", 6);   if(v < 24) g_alarm1.hh = v;
  v = prefs.getUChar("alm0mm", 30);  if(v < 60) g_alarm1.mm = v;
  g_alarm1.enabled = prefs.getBool("alm0en", true);
  v = prefs.getUChar("vol",    20);  if(v <= 30) g_vol       = v;
  v = prefs.getUChar("nvol",   8);   if(v <= 30) g_night_vol = v;
  v = prefs.getUChar("avol",   25);  if(v <= 30) g_alarm_vol = v;
  v = prefs.getUChar("brday",   180); g_bright_day   = v;
  v = prefs.getUChar("brnight", 40);  g_bright_night = v;
  g_chime_en          = prefs.getBool("chime", true);
  v = prefs.getUChar("eggmm",  5);   if(v < 100) g_egg_set_mm = v;
  v = prefs.getUChar("eggss",  0);   if(v < 60)  g_egg_set_ss = v;
  v = prefs.getUChar("sndset", 0);   if(v <= 4)  g_sound_set  = v;
  g_use_12hr          = prefs.getBool("hr12",  false);
  g_temp_degF         = prefs.getBool("tempF", false);
  g_tz_offset_hours   = prefs.getShort("tz", 2);
  g_smoke_running      = prefs.getBool("smkrun",  false);
  g_smoke_paused       = prefs.getBool("smkpaus", false);
  g_smoke_start_unix   = prefs.getULong("smkstart", 0);
  g_smoke_pause_unix   = prefs.getULong("smkpu",    0);
  g_smoke_paused_accum = prefs.getULong("smkacc",   0);
  g_smoke_note         = prefs.getString("smknote", "");
  g_braai_enabled      = prefs.getBool("brEn",    false);
  g_braai_running      = prefs.getBool("brRun",   false);
  g_braai_paused       = prefs.getBool("brPaus",  false);
  g_braai_start_unix   = prefs.getULong("brStart", 0);
  g_braai_pause_unix   = prefs.getULong("brPu",    0);
  g_braai_paused_accum = prefs.getULong("brAcc",   0);
  g_braai_total_sec    = prefs.getUShort("brTotal", 600);
  g_braai_turn_sec     = prefs.getUShort("brTurn",  60);
  prefs.end();
  g_egg_mm = g_egg_set_mm;
  g_egg_ss = g_egg_set_ss;
}

void factory_reset_defaults(void) {
  prefs.begin("clock", false);
  prefs.clear();
  prefs.end();
  // WiFiManager config also cleared:
  WiFiManager wm;
  wm.resetSettings();
}

// ── Smoker Uptimer — elapsed seconds, RTC-based so it survives a reboot ──────
uint32_t smoke_elapsed_sec(void) {
  if(!g_smoke_running) return 0;
  uint32_t now_unix = rtc.now().unixtime();
  uint32_t paused = g_smoke_paused_accum;
  if(g_smoke_paused && now_unix > g_smoke_pause_unix) {
    paused += (now_unix - g_smoke_pause_unix);
  }
  if(now_unix <= g_smoke_start_unix) return 0;
  uint32_t raw = now_unix - g_smoke_start_unix;
  return (raw > paused) ? (raw - paused) : 0;
}

// ── Braai Timer — elapsed/remaining seconds, same RTC-based survive-reboot
// pattern as the Smoker Uptimer above, but this one counts DOWN to zero.
uint32_t braai_elapsed_sec(void) {
  if(!g_braai_running) return 0;
  uint32_t now_unix = rtc.now().unixtime();
  uint32_t paused = g_braai_paused_accum;
  if(g_braai_paused && now_unix > g_braai_pause_unix) {
    paused += (now_unix - g_braai_pause_unix);
  }
  if(now_unix <= g_braai_start_unix) return 0;
  uint32_t raw = now_unix - g_braai_start_unix;
  return (raw > paused) ? (raw - paused) : 0;
}

uint32_t braai_remaining_sec(void) {
  uint32_t elapsed = braai_elapsed_sec();
  return (elapsed < g_braai_total_sec) ? (g_braai_total_sec - elapsed) : 0;
}

/******************************************************************************
 * DFPlayer Mini — direct UART2 driver (no library needed)
 ******************************************************************************/
//  Frame: 7E FF 06 CMD 00 ParamH ParamL CsumH CsumL EF
//
//  REVERTED 2026-06-21: the "clone-safe" zero-checksum variant tried briefly
//  here was rolled back. A 0x00,0x00 checksum is not a valid frame on these
//  clone boards either — it doesn't bypass anything, it just gets rejected.
//  The real calculated checksum below is the version that was actually
//  confirmed working on 2026-06-17/18 once combined with the TF-card-select
//  command and the gapless track-mapping table further down this file.

void dfp_send(uint8_t cmd, uint8_t paramH, uint8_t paramL) {
  uint8_t buf[10];
  buf[0] = 0x7E; buf[1] = 0xFF; buf[2] = 0x06;
  buf[3] = cmd;  buf[4] = 0x00;
  buf[5] = paramH; buf[6] = paramL;
  int16_t chk = 0 - (int16_t)(buf[1]+buf[2]+buf[3]+buf[4]+buf[5]+buf[6]);
  buf[7] = (uint8_t)(chk >> 8);
  buf[8] = (uint8_t)(chk & 0xFF);
  buf[9] = 0xEF;
  Serial2.write(buf, 10);
}

/******************************************************************************
 * DFPlayer logical → physical track mapping
 ******************************************************************************/
//  This particular module (clone chip) plays files by their PHYSICAL WRITE
//  ORDER on the SD card, not by the digits in the filename. Gapped numbering
//  (e.g. 0001, 0002, 0010, 0011...) caused "track not found" errors past the
//  total file count. Fix applied 2026-06-18: all files renumbered into one
//  gapless sequential block (0001.mp3 .. 0026.mp3) on the card.
//
//  The rest of the firmware still uses the original MEANINGFUL track numbers
//  (alarm=1, MED_TRACK=62, chime_track_for_set() formula, etc.) — this table
//  converts those logical numbers into the actual physical position on the
//  card. dfplayer_play() runs every track number through this before sending.
//
//  IMPORTANT: if you add, remove, or re-copy files on the SD card later, the
//  physical positions can shift again — re-verify with the standalone test
//  sketch and update this table to match.
//  Updated 2026-06-18: missing chime (logical 22) recorded and added —
//  card is now a complete, gapless 27-file sequence (0001.mp3-0027.mp3).
struct DfpTrackMap { uint16_t logical; uint8_t physical; };
static const DfpTrackMap DFP_TRACK_MAP[] = {
  {  1,  1},   // alarm fire sound
  {  2,  2},   // egg timer alert
  { 10,  3},   // chime set 0, quarter 0
  { 11,  4},   // chime set 0, quarter 1
  { 12,  5},   // chime set 0, quarter 2
  { 13,  6},   // chime set 0, quarter 3
  { 14,  7},   // volume up/down confirmation beep
  { 20,  8},   // chime set 1, quarter 0
  { 21,  9},   // chime set 1, quarter 1
  { 22, 10},   // chime set 1, quarter 2  ← previously missing, now recorded
  { 23, 11},   // chime set 1, quarter 3
  { 30, 12},   // chime set 2, quarter 0
  { 31, 13},   // chime set 2, quarter 1
  { 32, 14},   // chime set 2, quarter 2
  { 33, 15},   // chime set 2, quarter 3
  { 40, 16},   // chime set 3, quarter 0
  { 41, 17},   // chime set 3, quarter 1
  { 42, 18},   // chime set 3, quarter 2
  { 43, 19},   // chime set 3, quarter 3
  { 50, 20},   // chime set 4, quarter 0
  { 51, 21},   // chime set 4, quarter 1
  { 52, 22},   // chime set 4, quarter 2
  { 53, 23},   // chime set 4, quarter 3
  { 61, 24},   // PILL_TRACK  — "Pille geneem!"
  { 62, 25},   // MED_TRACK   — "Medisyne tyd Ouma!"
  { 63, 26},   // BDAY_TRACK  — "Veels geluk met jou verjaarsdag!"
  { 64, 27},   // DOC_TRACK   — "Doktersafspraak vandag!"
};
#define DFP_TRACK_MAP_SIZE (sizeof(DFP_TRACK_MAP)/sizeof(DFP_TRACK_MAP[0]))

uint8_t dfp_physical_track(uint16_t logical) {
  for(uint8_t i = 0; i < DFP_TRACK_MAP_SIZE; i++) {
    if(DFP_TRACK_MAP[i].logical == logical) return DFP_TRACK_MAP[i].physical;
  }
  Serial.printf("DFPlayer: no SD card mapping for logical track %u — recording missing?\n", logical);
  return 0;   // module will just reply with an error; harmless
}

void dfplayer_volume(uint8_t vol) {
  dfp_send(0x06, 0, vol);
  delay(30);   // settling delay between commands — the one change worth testing
               // in isolation on a clone chip; kept, but the real checksum and
               // the bounded flush loop below are restored alongside it.
}

void dfplayer_play(uint16_t t) {
  uint8_t phys = dfp_physical_track(t);
  if(phys == 0) {
    Serial.printf("DFPlayer PLAY skipped: logical=%u has no SD mapping\n", t);
    return;
  }
  Serial.printf("DFPlayer PLAY: logical=%u physical=%u\n", t, phys);

  // SAFETY: hard time limit on every flush loop below. A noisy/floating RX
  // line (e.g. a loose wire) could otherwise make available() stay true
  // forever and freeze the entire firmware — this guarantees it can't.
  uint32_t flush_start = millis();
  while(Serial2.available() && (millis() - flush_start < 50)) Serial2.read();
  dfp_send(0x03, 0, phys);

  // ── TEMPORARY DIAGNOSTIC (2026-06-23, v2) — removing the reply-read
  // entirely caused total silence, so the read itself is needed. This
  // version listens IMMEDIATELY (no fixed delay(100) gap beforehand) and
  // for a shorter window, in case the original fixed 100ms delay — sitting
  // idle, neither reading nor sending — was itself the problem, rather
  // than the read/log loop.
  uint32_t reply_start = millis();
  bool got_reply = false;
  while(millis() - reply_start < 60) {
    if(Serial2.available()) {
      got_reply = true;
      Serial.print(" reply bytes: ");
      uint32_t inner_start = millis();
      while(Serial2.available() && (millis() - inner_start < 50)) {
        Serial.printf("%02X ", Serial2.read());
      }
      Serial.println();
      break;
    }
  }
  if(!got_reply) {
    Serial.println(" (no immediate reply — module may still be processing, that's normal)");
  }
}

void dfplayer_stop(void) { dfp_send(0x16, 0, 0); }

/******************************************************************************
 * Bar3 — the single combined 30-LED chain (pills + meds + free/status)
 ******************************************************************************/
//  Mirrors pill_leds[]/med_leds[] into their slice of the physical chain, then
//  draws the free/status bar (indices 20-29) purely from current state flags.
//  This is now the ONLY place that decides status-indicator colours — the old
//  scattered leds[0]/leds[1] writes and full-matrix fill_solid() alarm flashes
//  throughout the security code have been removed; everything routes through
//  here instead. Saves power when away (no more full 256-LED flashing for
//  minutes/hours) and keeps the main clock display showing the time normally
//  even while an alarm or siren is sounding.
void compose_bar3(void) {
  for(uint8_t i = 0; i < PILL_NUM_LEDS; i++) bar3_leds[PILL_BASE + i] = pill_leds[i];
  for(uint8_t i = 0; i < MED_NUM_LEDS;  i++) bar3_leds[MED_BASE  + i] = med_leds[i];

  // ── Free bar [20][21] = security/alarm status, priority order ─────────────
  uint32_t ms = millis();
  CRGB s;
  if(g_panic_active) {
    s = ((ms / 100) % 2 == 0) ? CRGB(255, 0, 0) : CRGB(255, 255, 255);       // panic — fast
  } else if(g_sec_triggered) {
    s = ((ms / 150) % 2 == 0) ? CRGB(255, 0, 0) : CRGB(255, 255, 255);       // siren wailing
  } else if(g_sec_entry_delay) {
    s = ((ms / 300) % 2 == 0) ? CRGB(220, 0, 0) : CRGB::Black;               // entry countdown
  } else if(g_sec_exit_delay) {
    s = ((ms / 500) % 2 == 0) ? CRGB(255, 100, 0) : CRGB::Black;             // exit countdown
  } else if(g_disarm_lockout_ms > 0) {
    s = CRGB(0, 128, 0);                                                     // just disarmed (20% dimmer than before)
  } else if(g_alm_fire && !g_wekker_ringing) {
    s = ((ms / 300) % 2 == 0) ? CRGB(200, 0, 0) : CRGB::Black;               // clock alarm ringing
    // (g_alm_fire is also true while a Wekker rings — they share the flag
    // for the underlying ring/repeat mechanism — but Wekkers get their own
    // dedicated indicator below [29], so they're deliberately excluded here.
    // This keeps the top-2 slot solely for genuine security/wake-alarm
    // states: no more wondering whether a flash means an intruder or just
    // Ouma's 06:30 Wekker going off.)
  } else {
    s = g_z2_armed ? CRGB(255, 100, 0) : CRGB(0, 128, 0);                     // armed = solid orange, disarmed = green (20% dimmer than before)
  }
  bar3_leds[FREE_BASE + 0] = s;
  bar3_leds[FREE_BASE + 1] = s;

  // [22] = 12hr/24hr indicator   [23] = °C/°F indicator
  bar3_leds[FREE_BASE + 2] = g_use_12hr  ? CRGB(40, 40, 40) : CRGB::Black;
  bar3_leds[FREE_BASE + 3] = g_temp_degF ? CRGB(60, 30, 0)  : CRGB(0, 0, 40);

  // [24] = AM/PM (only meaningful in 12hr mode) — blue=AM, red=PM
  if(g_use_12hr) {
    bar3_leds[FREE_BASE + 4] = (g_hh >= 12) ? CRGB(180, 0, 0) : CRGB(0, 0, 150);
  } else {
    bar3_leds[FREE_BASE + 4] = CRGB::Black;
  }

  // [25] = DFPlayer boot health — green=responded, dim red=no response.
  // Lets you check at a glance whether DFPlayer is alive without any PC/serial.
  bar3_leds[FREE_BASE + 5] = g_dfp_alive ? CRGB(0, 60, 0) : CRGB(60, 0, 0);

  // [26] = Zone 1 (courtyard) armed/disarmed.
  // Independent of the main [20][21] status LED, which shows overall
  // alarm/siren/exit-delay state. This one ONLY answers "are the courtyard
  // PIRs actually watching right now" — useful because g_z1_active can in
  // principle be suspended on its own (see the courtyard-pause web route)
  // even while the rest of the system shows a different state.
  // UPDATED: watching/armed now shows the SAME green as the top-2 disarmed
  // indicator (was orange), and paused/disarmed now flashes red (was solid
  // green) so a paused courtyard reads as a warning, not an all-clear.
  if (g_z1_active) {
    bar3_leds[FREE_BASE + 6] = CRGB(0, 128, 0);                                 // watching/armed = green (matches top-2 disarmed shade)
  } else {
    bar3_leds[FREE_BASE + 6] = ((ms / 300) % 2 == 0) ? CRGB(200, 0, 0) : CRGB::Black;  // paused/disarmed = flashing red
  }

  // [27] = Internet reachability Henry's request.
  // WiFi-connected is NOT the same as internet-up (loadshedding: router on
  // UPS, fibre/ONT dead). g_inet_ok is refreshed every 30s by a bounded TCP
  // probe in wifi_task(). Blue = internet reachable, dim red = WiFi up but no
  // internet (or WiFi down). Distinct blue so it's not confused with the
  // green/orange security LEDs beside it. Complements the "NTP Yes/No" text on
  // the main status page but updates every 30s instead of every 6 hours.
  bar3_leds[FREE_BASE + 7] = g_inet_ok ? CRGB(0, 40, 120) : CRGB(50, 0, 0);

  // [28] = Kalender event countdown . Magenta so it's
  // distinct from the doctor LED's cyan. Same countdown language: soft pulse
  // at 3 days, brighter at 2, fast at 1, flashing on the day. Driven by
  // g_evt_today / g_evt_days_min, refreshed every second in evt_check().
  if (g_evt_days_min > 3) {
    bar3_leds[FREE_BASE + 8] = CRGB::Black;
  } else if (g_evt_today && !g_evt_acked) {
    bar3_leds[FREE_BASE + 8] = ((ms / 300) % 2 == 0) ? CRGB(200, 0, 180) : CRGB::Black;
  } else if (g_evt_today) {
    // Acknowledged — steady soft magenta instead of flashing
    bar3_leds[FREE_BASE + 8] = CRGB(60, 0, 54);
  } else {
    uint8_t p28 = (uint8_t)(30 + 30 * sin(ms / (g_evt_days_min == 1 ? 350.0 : (g_evt_days_min == 2 ? 700.0 : 1200.0))));
    bar3_leds[FREE_BASE + 8] = CRGB(p28, 0, (uint8_t)(p28 * 0.9));
  }

  // [29] = Wekkers ringing indicator (Henry's request) — deliberately amber,
  // nowhere near the red/white family used by Emergency/PIR/wake-alarm above,
  // so a glance at the status bar can never confuse "someone's Wekker is
  // going off" with "there is a security concern."
  bar3_leds[FREE_BASE + 9] = g_wekker_ringing
    ? (((ms / 300) % 2 == 0) ? CRGB(255, 170, 0) : CRGB::Black)
    : CRGB::Black;
}

void leds_show_all(void) {
  compose_bar3();

  // ── Independent per-strip brightness — NEW 2026-06-27 ─────────────────────
  // FastLED.setBrightness() is GLOBAL — it scales every strip registered with
  // FastLED.addLeds() identically. That's why fixing BAR3 (pills/meds/status)
  // to the day/night schedule also froze the MAIN matrix display, which is
  // meant to keep following the BH1750 ambient sensor as before.
  //
  // Fix: use FastLED's own per-controller show — CFastLED::operator[] returns
  // each registered controller in registration order, and .showLeds(bright)
  // pushes JUST that controller's buffer at JUST that brightness, leaving
  // leds[]/bar3_leds[] colour data completely untouched (no compounding, no
  // copies, no risk of double-scaling on the next frame).
  //
  //   controller 0 = leds[]      (main matrix)      → g_bright
  //                  (BH1750 lux-driven, see update_brightness_smooth())
  //   controller 1 = bar3_leds[] (pills/meds/status) → g_bar3_bright
  //                  (fixed day/night schedule, see update_bar3_brightness())
  //
  // Registration order is set once in setup() — see the two
  // FastLED.addLeds<...>() calls — and must stay leds[] first, bar3_leds[]
  // second for these indices to stay correct.
  FastLED[0].showLeds(g_bright);
  FastLED[1].showLeds(g_bar3_bright);
}

bool is_night_now(void) {
  if(NIGHT_START > NIGHT_END)
    return (g_hh >= NIGHT_START || g_hh < NIGHT_END);
  return (g_hh >= NIGHT_START && g_hh < NIGHT_END);
}

uint16_t chime_track_for_set(uint8_t ss, uint8_t q) {
  return (uint16_t)(ss * 10 + 10 + q);
}

/******************************************************************************
 * Birthday Calendar Functions
 ******************************************************************************/

// Returns days until next occurrence of day/month from today (0 = today, 1 = tomorrow, etc.)
int16_t days_until_bday(uint8_t bday_day, uint8_t bday_month) {
  // 29 Feb birthdays could NEVER match — dim[2] is 28,
  // so the walk below never lands on 29/2 and returned 999 forever (birthday
  // invisible, no announcement, ever). Leap-year babies now celebrate on
  // 1 March, the common convention. (2028 is the next actual 29 Feb; a fully
  // leap-aware walk needs year tracking — not worth it for a countdown LED.)
  if (bday_day == 29 && bday_month == 2) { bday_day = 1; bday_month = 3; }
  uint8_t cur_mm = g_month, cur_dd = g_day;
  static const uint8_t dim[] = {0,31,28,31,30,31,30,31,31,30,31,30,31};
  for (int16_t offset = 0; offset <= 365; offset++) {
    if (cur_dd == bday_day && cur_mm == bday_month) return offset;
    cur_dd++;
    if (cur_dd > dim[cur_mm]) { cur_dd = 1; cur_mm++; if (cur_mm > 12) cur_mm = 1; }
  }
  return 999;
}

void bday_save(void) {
  Preferences p;
  p.begin("bday", false);
  p.putUChar("count", g_bday_count);
  for (uint8_t i = 0; i < g_bday_count; i++) {
    String k = String(i);
    p.putUChar(("d"  + k).c_str(), g_bdays[i].day);
    p.putUChar(("m"  + k).c_str(), g_bdays[i].month);
    p.putString(("n" + k).c_str(), g_bdays[i].name);
  }
  p.putUChar("lastday", g_bday_last_day);
  p.putBool ("acked",   g_bday_acked);
  p.putBool ("played",  g_bday_played);
  p.end();
}

void bday_load(void) {
  Preferences p;
  p.begin("bday", true);
  g_bday_count    = p.getUChar("count", 0);
  if (g_bday_count > BDAY_MAX) g_bday_count = BDAY_MAX;
  for (uint8_t i = 0; i < g_bday_count; i++) {
    String k = String(i);
    g_bdays[i].day   = p.getUChar(("d" + k).c_str(), 1);
    g_bdays[i].month = p.getUChar(("m" + k).c_str(), 1);
    String nm = p.getString(("n" + k).c_str(), "");
    strncpy(g_bdays[i].name, nm.c_str(), 13);
    g_bdays[i].name[13] = '\0';
  }
  g_bday_last_day = p.getUChar("lastday", 255);
  g_bday_acked    = p.getBool ("acked",   false);
  g_bday_played   = p.getBool ("played",  false);
  p.end();
}

// Call once per second — checks for birthday, resets ack at midnight
void bday_check(void) {
  // Reset ack + played flag on new day
  if (g_day != g_bday_last_day) {
    g_bday_last_day = g_day;
    g_bday_acked    = false;
    g_bday_played   = false;
    g_bday_today    = false;
    g_bday_today_idx = 255;
    bday_save();
  }

  // Check if any birthday is today
  g_bday_today    = false;
  g_bday_today_idx = 255;
  for (uint8_t i = 0; i < g_bday_count; i++) {
    if (g_bdays[i].day == g_day && g_bdays[i].month == g_month) {
      g_bday_today     = true;
      g_bday_today_idx = i;
      break;
    }
  }

  // Play MP3 at 08:40 on the birthday day (was 00:00 — nobody's awake then!)
  // Uses alarm volume (g_alarm_vol) so it's coupled to the Alarm volume
  // setting, same as other "must hear" alerts (egg timer, wekkers, etc).
  if (g_bday_today && !g_bday_played && g_hh == 8 && g_mm == 40) {
    g_bday_played = true;
    dfplayer_volume(g_alarm_vol);
    dfplayer_play(BDAY_TRACK); voice_lock();
    bday_save();
  }
}

// Render birthday LEDs on med strip LEDs 4, 5, 6
// LED 4 = 3 days away (soft purple)
// LED 5 = 2 days away (medium purple)
// LED 6 = 1 day away or TODAY (fast flash or rainbow)
void bday_render_leds(void) {
  uint8_t bright = is_night_now() ? 15 : 80;

  // Default: all three off
  med_leds[BDAY_LED_3] = CRGB::Black;
  med_leds[BDAY_LED_2] = CRGB::Black;
  med_leds[BDAY_LED_1] = CRGB::Black;

  // Find closest upcoming birthday
  int16_t min_days = 999;
  for (uint8_t i = 0; i < g_bday_count; i++) {
    int16_t d = days_until_bday(g_bdays[i].day, g_bdays[i].month);
    if (d < min_days) min_days = d;
  }

  if (min_days > 3) return;  // nothing within 3 days

  uint8_t pulse = (uint8_t)(40 + 40 * sin(millis() / 600.0));
  bool flash_fast = ((millis() / 250) % 2 == 0);

  if (min_days == 3) {
    // 3 days away — soft purple on LED 4 only
    med_leds[BDAY_LED_3] = CRGB(pulse / 2, 0, pulse);
  }
  else if (min_days == 2) {
    // 2 days away — purple on LEDs 4 and 5
    med_leds[BDAY_LED_3] = CRGB(bright / 3, 0, bright / 2);
    med_leds[BDAY_LED_2] = CRGB(pulse / 2, 0, pulse);
  }
  else if (min_days == 1) {
    // Tomorrow! — all 3 LEDs, brighter purple pulse
    med_leds[BDAY_LED_3] = CRGB(bright / 2, 0, bright);
    med_leds[BDAY_LED_2] = CRGB(bright / 2, 0, bright);
    med_leds[BDAY_LED_1] = CRGB(pulse,      0, pulse * 2 > 255 ? 255 : pulse * 2);
  }
  else if (min_days == 0) {
    // TODAY! — all 3 flash rainbow if not acked, else steady gold
    if (!g_bday_acked) {
      uint8_t hue = (millis() / 20) % 256;
      med_leds[BDAY_LED_3] = CHSV(hue,        255, bright);
      med_leds[BDAY_LED_2] = CHSV(hue + 85,   255, bright);
      med_leds[BDAY_LED_1] = flash_fast ? CRGB(CHSV(hue + 170, 255, bright)) : CRGB::Black;
    } else {
      // Acknowledged — steady soft gold
      med_leds[BDAY_LED_3] = CRGB(bright, bright / 2, 0);
      med_leds[BDAY_LED_2] = CRGB(bright, bright / 2, 0);
      med_leds[BDAY_LED_1] = CRGB(bright, bright / 2, 0);
    }
  }
}
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
